santi-bnt/C.U.T.Y/hardware/README.md

# C.U.T.Y Hardware

Dos áreas: [CAD](cad/README.md), con fuentes nativas SolidWorks y exportaciones, y [electrónica](electronics/README.md), con KiCad, esquemas y datasheets. El firmware sigue separado en `../stm32/`. No se han convertido ni sustituido diseños.

- **Carcasa imprimible V17 «Nido»:** [cad/carcasa_v17](cad/carcasa_v17/LEEME.md), 30 piezas que se arman sin pegamento.
- **Carcasa V17 fija:** [cad/carcasa_v17_fija](cad/carcasa_v17_fija/LEEME.md), la misma carcasa sobre un pedestal bajo, sin movimiento en la base (27 piezas, 3 servos, 31.6 cm).
- **Placa base v1.1, pedida ensamblada a JLCPCB:** [electronics/kicad/cuty_carrier/fab/jlcpcb](electronics/kicad/cuty_carrier/fab/jlcpcb/LEEME_JLCPCB.md) (archivos subidos y correcciones del visor). Los de PCBWay quedan como alternativa en [fab/pcba](electronics/kicad/cuty_carrier/fab/pcba/LEEME_PCBA.md).
- **Lista de materiales real:** [docs/bom.md](../docs/bom.md).
