santi-bnt/C.U.T.Y/raspberry/README.md

# C.U.T.Y — Phase 1

C.U.T.Y is a small voice companion running on a Windows PC. Speak into the computer microphone and hear a streamed reply through the computer speakers. A live audio session keeps conversational context until you quit. No robot hardware is used. Gemini Live is the default provider because its selected native-audio model has a limited free API tier; OpenAI remains optional.

## Windows 11 setup

In PowerShell, from the repository root, first run `cd raspberry`:

```powershell
python -m venv .venv
.\.venv\Scripts\Activate.ps1
python -m pip install -r requirements.txt
```

If PowerShell blocks activation, use `.\.venv\Scripts\python.exe` in place of `python` for the commands below.

Create a free-tier API key in [Google AI Studio](https://aistudio.google.com/app/apikey). Keep the project on the Free tier if you do not want billing. Enter the key for the current PowerShell session:

```powershell
$env:GEMINI_API_KEY = Read-Host "Enter your Gemini API key"
```

Or copy `.env.example` to `.env` and replace `your_key_here` with the real value. `.env` is ignored by Git. An existing `GEMINI_API_KEY` environment variable takes precedence over `.env`. The key is never logged. Do not share it or commit it. A previously set `OPENAI_API_KEY` does not affect the default Gemini provider.

List audio devices without an API key:

```powershell
python -m cuty --list-audio-devices
```

To check whether Windows is delivering your voice to C.U.T.Y, run this without an API key and speak normally for three seconds:

```powershell
python -m cuty --test-microphone
```

`Peak` and `RMS` should rise above zero while you speak. This test does not save or transmit the recording. If the level stays near zero, check Windows microphone privacy permissions, mute/input volume, and the chosen device.

Choose device indices from that list if the defaults do not work:

```powershell
$env:CUTY_AUDIO_INPUT_DEVICE = "1"
$env:CUTY_AUDIO_OUTPUT_DEVICE = "4"
```

At startup C.U.T.Y opens each selected device briefly to check that it works. If a Windows default uses a failing MME driver, it tries another interface for the same named device. Device indices can change when a headset or other audio device is connected.

Start C.U.T.Y:

```powershell
python -m cuty
```

Press ENTER to start recording, speak, and press ENTER again to stop. C.U.T.Y streams its spoken answer. Repeat for another turn; say your name, then ask it to recall your name. Type `q` and ENTER at the idle prompt to quit. The current mode waits for each answer before you can speak again.

C.U.T.Y is instructed to answer in the language of your latest spoken question automatically, switching between turns (English in, English out; Spanish in, Spanish out; likewise for other languages supported by the voice model). An explicit request for a particular response language takes priority. Mixed-language questions use their main language. This applies to AI replies; the fixed local thinking asides described below are still Spanish. Restart the app after changing the instructions in `src/cuty/brain/personality.py` so a new session receives them.

During waits longer than five seconds, C.U.T.Y can say one brief Spanish aside, such as "Dame un momento" or "Estoy revisando". Fast replies have no filler. Once an aside starts, it finishes before the answer plays, so phrases are not cut off or mixed with the reply. Errors and leaving the conversation stop it after the current small audio chunk. `src/cuty/audio/thinking.py` contains the editable phrase list. The phrases use a separate Mexican Spanish voice through [Edge TTS](https://github.com/rany2/edge-tts), which needs internet but no additional API key. Only fixed phrases are sent to this service, never microphone recordings or conversation contents. They are cached in memory; if the service fails, conversation still works without asides.

In a successful turn, expect `[AI] Connected to Gemini Live` once, then `[CUTY] STATE -> LISTENING`, `THINKING`, `SPEAKING`, and `IDLE`. `[CUTY FACE]` lines show baseline expressions and any emotion chosen by the model.

The default model is `gemini-3.8-live`, Google's current stable Live model for low-latency voice agents. Its audio input and output are listed as free on the Gemini API Free tier, subject to quotas. Free-tier content may be used to improve Google products. Check Google's [models](https://ai.google.dev/gemini-api/docs/models) and [pricing](https://ai.google.dev/gemini-api/docs/pricing) pages for current availability and limits. Do not enable billing on the AI Studio project if you want a firm no-charge boundary.

Gemini can call `search_web` for current information through the public DDGS search library, without another API key or a Google Search API quota. Ask, for example, "Busca en internet cuál es la versión estable actual de Python y dime la fuente." C.U.T.Y replies by voice and logs actual queries and source links as `[WEB]`. Ordinary conversation does not need a search; a lookup may take longer. Searches return public page excerpts, not full browser sessions or actions on websites. The public search engines can rate-limit or become unavailable; C.U.T.Y reports an unsuccessful search instead of inventing a verified answer. This integration avoids the Gemini Live Google Search quota restriction observed on the configured free project. The optional OpenAI adapter does not enable this search tool.

## ReSpeaker on the Pi, reply audio on a Windows PC

Run the voice app on the Raspberry Pi, where the ReSpeaker is connected.
The PC only receives reply audio. Both machines need the Python dependencies
above. This temporary setup uses an SSH reverse tunnel, with the audio
receiver listening only on localhost; no Windows inbound firewall rule is needed.

On the PC, open PowerShell in `raspberry`, list devices, choose the index of
your PC speakers (not the ReSpeaker), and leave the receiver running:

```powershell
.\.venv\Scripts\python.exe -m cuty --list-audio-devices
$env:CUTY_AUDIO_OUTPUT_DEVICE = "3" # Replace with your Speakers index
.\.venv\Scripts\python.exe -m cuty --serve-audio
```

In a second PC terminal, connect to the Pi (replace the user and host):

```powershell
ssh -o ExitOnForwardFailure=yes -R 8765:127.0.0.1:8765 santi@RASPBERRY_IP
```

Inside that SSH session, from the repository root on the Pi:

```bash
git pull --ff-only origin main
cd raspberry
source .venv/bin/activate
python -m pip install -r requirements.txt
python -m cuty --list-audio-devices
export CUTY_AUDIO_INPUT_DEVICE="N" # Replace N with the ReSpeaker input index
python -m cuty --test-microphone
export CUTY_AUDIO_REMOTE_OUTPUT="127.0.0.1:8765"
# Configure GEMINI_API_KEY locally on the Pi if it is not already in .env.
python -m cuty
```

If no virtual environment exists on the Pi, create it first with
`python3 -m venv .venv`. Speak during the three-second microphone test;
Peak and RMS should rise above zero. Then press ENTER, speak into the Pi's
ReSpeaker, and press ENTER again: the reply plays on the PC. Keep both PC
terminals open. Ctrl+C stops the receiver; `q` quits the voice app.
Unset `CUTY_AUDIO_REMOTE_OUTPUT` to restore local Pi playback.
If the ReSpeaker does not appear on the Pi, its USB/HAT setup must be resolved
before testing the voice app. Lip sync still runs on the Pi; network latency
may require adjusting `CUTY_LIPSYNC_DELAY`.

## Conversación automática en la pantalla

El botón C.U.T.Y del menú inicia una sesión Gemini con saludo hablado y
escucha sin ENTER. Di «salir», «quiero salir» o «regresa al menú principal»
cuando escuche para volver al inicio. El launcher utiliza este entorno
virtual y carga `raspberry/.env`; no recibe las variables exportadas en una
terminal SSH. Consulta la [configuración del menú](touchscreen/README.md#conversación-desde-el-menú).

Para probar ese modo desde una terminal: `python -m cuty --hands-free`.
La CLI habitual `python -m cuty` conserva los turnos con ENTER.

## Tests

```powershell
python -m pytest -q
```

Tests use fakes and never call either AI API or require audio hardware. A real voice test requires a valid Gemini key, an accessible microphone and speaker, network access, and free-tier model access in your account. Override the Gemini model with `CUTY_GEMINI_MODEL` only if Google's availability changes.

The CLI logs connection and state changes, expression events, assistant transcripts, and Gemini's input transcription as `Escuché: ...`. If the local microphone test shows voice but no `Escuché` line appears during a turn, check that you spoke after the first ENTER and pressed ENTER again only after finishing. If microphone capture or speaker playback fails, check Windows microphone permission and try a different device index. If a connection fails temporarily, startup retries three times with short exponential delays. A disconnect during a turn ends the program so it does not silently lose session memory; start it again for a new session.

## Architecture

Hands-free voice and local Music Mode have independent software output volume
controls. See [volume commands and Raspberry Pi validation](../docs/voice-volume.md).
Vision timing, Gemini request diagnosis, and the opt-in high-resolution camera
experiment are documented in [vision performance](../docs/vision-performance.md).

`src/cuty/brain/` owns conversation and states; `llm/` owns both cloud providers and web lookup; `audio/` owns microphone, speaker, and thinking asides. `src/cuty/main.py` is the entry point and `app.py` wires the CLI. `face/` contains expression events, the animated touchscreen face and the UDP link that carries expressions and lip-sync levels to it; `vision/` tracks the person for the eyes. Other robot modules are placeholders; see [architecture](../docs/architecture.md).

Baseline expressions follow `IDLE`, `LISTENING`, `THINKING`, and `SPEAKING` states. The model may call `set_expression` for a temporary emotion. Invalid tool arguments are rejected and returned to the model without emitting a robot event. No keyword-based emotion matching is used. There is no serial transport or defined UART protocol in this phase.

Gemini Live uses explicit activity boundaries: the first microphone chunk starts the user turn, and ENTER sends its end immediately. This avoids a separate server-side silence wait and prevents premature responses during a pause. Input is native 16 kHz PCM and output is 24 kHz PCM. Server events and speaker playback run independently, so expression tool results are submitted while audio plays. Expression calls explicitly use blocking mode so Gemini resumes speech after the result instead of silently completing an expression-only turn. The CLI logs `Primera voz en ... s` from the end of recording to the first playback chunk and reports an error if no voice arrives in 15 seconds or the server finishes without audio. The session keeps context in memory on the live connection. There is no long-term memory, wake word, hands-free turn control, or barge-in in Phase 1.

Implementation references: [Gemini Live capabilities](https://ai.google.dev/gemini-api/docs/live-api/capabilities) and [Gemini Live tools](https://ai.google.dev/gemini-api/docs/live-api/tools).

To use the optional OpenAI provider instead, set `CUTY_AI_PROVIDER=openai` and `OPENAI_API_KEY` in the environment; its default model is `gpt-realtime-2.1`. OpenAI API usage is billed separately. The earlier OpenAI integration and tests remain available.

## Later Raspberry Pi OS deployment

The same Python package is intended to install on 64-bit Raspberry Pi OS:

```bash
git clone <repository-url>
cd <repository-directory>/raspberry
python3 -m venv .venv
source .venv/bin/activate
python -m pip install -r requirements.txt
export GEMINI_API_KEY='your-real-key'
python -m cuty
```

The sample `systemd/cuty.service` is a placeholder for a later phase. This Phase 1 CLI needs keyboard input, so the unit should not be activated until a noninteractive interaction mode is added and tested on the Pi.

## Raspberry touchscreen

The [touch menu, animated face and Wi-Fi panel](touchscreen/README.md) live in `touchscreen/`. The C.U.T.Y button starts hands-free Gemini voice, expressions and lip sync, with a spoken exit back to the menu. Screen dependencies are in `touchscreen/requirements.txt` and are not required for Windows voice development. Setup helpers live in `scripts/` within this Raspberry directory.

## Local Music Mode (experimental; physical Pi validation required)

In touchscreen hands-free mode, voice transcripts are checked by a deterministic Spanish/English command parser. The first provider is a local file library; no audio is bundled. Put audio you are authorized to play under `~/Music/CUTY` (or set `CUTY_MUSIC_DIR`) and optionally set `CUTY_MUSIC_VOLUME` from 0 to 100. Supported containers are WAV, MP3, FLAC, OGG, and M4A when the installed PyAV/FFmpeg build can decode them. Commands include play/search, pause, continue, stop, next, previous, volume up/down/set, and current-track query. The local provider uses the existing speaker and PyAV dependency; music output is deliberately kept outside the speech lip-sync wrapper. The face process remains independent and receives a gentle happy expression during music, not beat-synchronized animation.

The existing hands-free application uses half-duplex audio: it pauses music and closes the output stream while the microphone records, then resumes music after the voice reply if it was playing. When a local track starts, hands-free waits for that track to finish before reopening its microphone; this allows an initial full-track speaker/face test without falsely claiming voice interruption works. Voice pause/stop/volume commands therefore do not work during active playback yet. This is **not automatic volume ducking** and it is not acoustic echo cancellation. `--test-duplex` only tests a silent output stream while capturing the microphone; it does not prove audible speaker output or safe voice recognition over music. Validate actual speaker playback, ReSpeaker simultaneous capture/playback, echo, VAD, and volume behavior on the robot before enabling interruption or ducking.

On-demand voice vision and consent-based local face matching reuse the touchscreen FaceTracker camera. They require a separately installed OpenCV-contrib/SFace model and remain unvalidated on the Raspberry Pi; setup, privacy limits and required checks are in [`docs/face-vision.md`](../docs/face-vision.md).

There is no website backend, authentication, pairing, or robot transport in this repository: `web/src/communication/robot.ts` is explicitly an offline interface. No browser playback controls or public robot endpoint were added. A secure live dashboard requires an authenticated server/relay and device pairing, which are not present to integrate; credentials must not be placed in the static website. YouTube playback is not implemented. Its official APIs do not authorize extracting audio or hiding/playing audio in the background, so this local speaker provider is the compatible first step.
