santi-bnt/C.U.T.Y/stm32/Core/README.md

# STM32 Core

Reserved for the STM32F401 Black Pill board-specific startup, interrupt, and HAL initialization project. Confirm the exact MCU variant and board revision before generation. No generated or vendor code is present.
