santi-bnt/C.U.T.Y/stm32/Drivers/README.md

# STM32 Drivers

Reserved for STM32F401-compatible CMSIS/HAL and device drivers for the Black Pill. Keep vendor licensing and versions with imported code; no drivers are supplied now.
