santi-bnt/C.U.T.Y/web/digital-twin/README.md

# Digital Twin Placeholder

models/ and animations/ will hold web visualization assets. Derive geometry from reviewed CAD exports; these are not mechanical source-of-truth files. No renderer or simulation is implemented.
