santi-bnt/C.U.T.Y/docs/protocol/README.md

# C.U.T.Y Shared Contracts

Hardware-independent design documents for Raspberry ↔ STM32 ↔ telemetry consumers. [Protocol](protocol.md), [commands](commands.md), and [telemetry](telemetry.md) are proposals, not implemented or stable contracts. Keep board drivers and UI code out of this folder.
