santi-bnt/C.U.T.Y/web/dashboard/README.md

# Dashboard Placeholder

No application is implemented. Future telemetry views are listed in ../README.md. Select transport/framework only in a later dashboard task.
