santi-bnt/C.U.T.Y/stm32/App/imu/README.md

# STM32 IMU

Future sensor initialization, acquisition, calibration, orientation estimation, timestamps, and validity reporting. Outputs feed STM32 body control and telemetry.

No sensor model, bus, driver, sample rate, or coordinate frame is selected. C/H files are TODO-only. The Raspberry and web dashboard consume reported measurements; they do not own the real-time feedback loop.
