santi-bnt/C.U.T.Y/hardware/electronics/kicad/cuty_carrier/drc_report.txt

** Drc report for /home/claude/c.u.t.y/hardware/electronics/kicad/cuty_carrier/cuty_carrier.kicad_pcb **
** Created on 2026-11-04 17:50:28 **

** Found 50 DRC violations **
[silk_overlap]: Silkscreen overlap
    Rule: board setup constraints silk; Severity: warning
    @(126.5600 mm, 51.2000 mm): PCB Text 'SW PRINCIPAL' on F.Silkscreen
    @(131.7000 mm, 51.5000 mm): Line on F.Silkscreen
[silk_overlap]: Silkscreen overlap
    Rule: board setup constraints silk; Severity: warning
    @(126.5600 mm, 51.2000 mm): PCB Text 'SW PRINCIPAL' on F.Silkscreen
    @(121.4200 mm, 60.8610 mm): Line on F.Silkscreen
[silk_overlap]: Silkscreen overlap
    Rule: board setup constraints silk; Severity: warning
    @(126.5600 mm, 51.2000 mm): PCB Text 'SW PRINCIPAL' on F.Silkscreen
    @(131.7000 mm, 50.9400 mm): Line on F.Silkscreen
[silk_overlap]: Silkscreen overlap
    Rule: board setup constraints silk; Severity: warning
    @(126.5600 mm, 53.0000 mm): Reference 'J2'
    @(131.7000 mm, 53.0000 mm): Line on F.Silkscreen
[silk_overlap]: Silkscreen overlap
    Rule: board setup constraints silk; Severity: warning
    @(129.0000 mm, 66.2000 mm): Reference 'F2'
    @(128.2100 mm, 66.2000 mm): Line on F.Silkscreen
[silk_overlap]: Silkscreen overlap
    Rule: board setup constraints silk; Severity: warning
    @(131.7000 mm, 60.8610 mm): Line on F.Silkscreen
    @(126.5600 mm, 51.2000 mm): PCB Text 'SW PRINCIPAL' on F.Silkscreen
[silk_overlap]: Silkscreen overlap
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
[silk_overlap]: Silkscreen overlap
    Rule: board setup constraints silk; Severity: warning
    @(197.4010 mm, 135.6138 mm): Footprint Text '5V' of U1
    @(198.3980 mm, 135.4952 mm): Rect on F.Silkscreen
[silk_overlap]: Silkscreen overlap
    Rule: board setup constraints silk; Severity: warning
    @(149.1000 mm, 120.0000 mm): Reference 'D1'
    @(146.3600 mm, 119.5700 mm): Line on F.Silkscreen
[silk_overlap]: Silkscreen overlap
    Rule: board setup constraints silk; Severity: warning
    @(138.7600 mm, 51.2000 mm): PCB Text 'BUCK IN' on F.Silkscreen
    @(143.9000 mm, 51.5000 mm): Line on F.Silkscreen
[silk_overlap]: Silkscreen overlap
    Rule: board setup constraints silk; Severity: warning
    @(138.7600 mm, 51.2000 mm): PCB Text 'BUCK IN' on F.Silkscreen
    @(143.9000 mm, 50.9400 mm): Line on F.Silkscreen
[silk_overlap]: Silkscreen overlap
    Rule: board setup constraints silk; Severity: warning
    @(138.7600 mm, 53.0000 mm): Reference 'J4'
    @(143.9000 mm, 53.0000 mm): Line on F.Silkscreen
[silk_overlap]: Silkscreen overlap
    Rule: board setup constraints silk; Severity: warning
    @(150.9600 mm, 51.2000 mm): PCB Text 'SW SERVOS' on F.Silkscreen
    @(156.1000 mm, 50.9400 mm): Line on F.Silkscreen
[silk_overlap]: Silkscreen overlap
    Rule: board setup constraints silk; Severity: warning
    @(150.9600 mm, 51.2000 mm): PCB Text 'SW SERVOS' on F.Silkscreen
    @(156.1000 mm, 51.5000 mm): Line on F.Silkscreen
[silk_overlap]: Silkscreen overlap
    Rule: board setup constraints silk; Severity: warning
    @(150.9600 mm, 53.0000 mm): Reference 'J3'
    @(156.1000 mm, 53.0000 mm): Line on F.Silkscreen
[silk_overlap]: Silkscreen overlap
    Rule: board setup constraints silk; Severity: warning
    @(149.0000 mm, 66.2000 mm): Reference 'F1'
    @(148.2100 mm, 66.2000 mm): Line on F.Silkscreen

** Found 0 unconnected pads **

** Found 0 Footprint errors **

** End of Report **
