santi-bnt/C.U.T.Y/hardware/electronics/kicad/cuty_carrier/fab/drc_report.txt

** Drc report for /home/claude/c.u.t.y/hardware/electronics/kicad/cuty_carrier/cuty_carrier.kicad_pcb **
** Created on 2026-11-03 05:46:13 **

** Found 50 DRC violations **
[silk_overlap]: Silkscreen overlap
    Rule: board setup constraints silk; Severity: warning
    @(117.8000 mm, 80.0000 mm): Reference 'R9'
    @(114.5400 mm, 80.4300 mm): Line on F.Silkscreen
[silk_overlap]: Silkscreen overlap
    Rule: board setup constraints silk; Severity: warning
    @(101.5000 mm, 94.0800 mm): PCB Text '+6V' on F.Silkscreen
    @(100.8400 mm, 86.4000 mm): Line on F.Silkscreen
[silk_overlap]: Silkscreen overlap
    Rule: board setup constraints silk; Severity: warning
    @(101.5000 mm, 94.0800 mm): PCB Text '+6V' on F.Silkscreen
    @(101.4000 mm, 86.4000 mm): Line on F.Silkscreen
[silk_overlap]: Silkscreen overlap
    Rule: board setup constraints silk; Severity: warning
    @(101.5000 mm, 94.0800 mm): PCB Text '+6V' on F.Silkscreen
    @(102.9000 mm, 86.4000 mm): Line on F.Silkscreen
[silk_overlap]: Silkscreen overlap
    Rule: board setup constraints silk; Severity: warning
    @(101.4000 mm, 86.4000 mm): Line on F.Silkscreen
    @(101.2000 mm, 89.0000 mm): PCB Text '-' on F.Silkscreen
[silk_overlap]: Silkscreen overlap
    Rule: board setup constraints silk; Severity: warning
    @(100.8400 mm, 86.4000 mm): Line on F.Silkscreen
    @(101.2000 mm, 89.0000 mm): PCB Text '-' on F.Silkscreen
[silk_overlap]: Silkscreen overlap
    Rule: board setup constraints silk; Severity: warning
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
    @(101.2000 mm, 77.5000 mm): PCB Text '+' on F.Silkscreen
    @(101.4000 mm, 74.9000 mm): Line on F.Silkscreen
[silk_overlap]: Silkscreen overlap
    Rule: board setup constraints silk; Severity: warning
    @(101.2000 mm, 77.5000 mm): PCB Text '+' on F.Silkscreen
    @(100.8400 mm, 74.9000 mm): Line on F.Silkscreen
[silk_overlap]: Silkscreen overlap
    Rule: board setup constraints silk; Severity: warning
    @(126.5600 mm, 51.2000 mm): PCB Text 'SW PRINCIPAL' on F.Silkscreen
    @(131.7000 mm, 51.5000 mm): Line on F.Silkscreen
[silk_overlap]: Silkscreen overlap
    Rule: board setup constraints silk; Severity: warning
    @(126.5600 mm, 51.2000 mm): PCB Text 'SW PRINCIPAL' on F.Silkscreen
    @(121.4200 mm, 60.8610 mm): Line on F.Silkscreen
[silk_overlap]: Silkscreen overlap
    Rule: board setup constraints silk; Severity: warning
    @(126.5600 mm, 51.2000 mm): PCB Text 'SW PRINCIPAL' on F.Silkscreen
    @(131.7000 mm, 50.9400 mm): Line on F.Silkscreen
[silk_overlap]: Silkscreen overlap
    Rule: board setup constraints silk; Severity: warning
    @(117.8000 mm, 75.2000 mm): Reference 'R10'
    @(114.5400 mm, 75.6300 mm): Line on F.Silkscreen
[silk_overlap]: Silkscreen overlap
    Rule: board setup constraints silk; Severity: warning
    @(126.5600 mm, 53.0000 mm): Reference 'J2'
    @(131.7000 mm, 53.0000 mm): Line on F.Silkscreen
[silk_overlap]: Silkscreen overlap
    Rule: board setup constraints silk; Severity: warning
    @(126.5600 mm, 51.2000 mm): PCB Text 'SW PRINCIPAL' on F.Silkscreen
    @(131.7000 mm, 60.8610 mm): Line on F.Silkscreen
[silk_overlap]: Silkscreen overlap
    Rule: board setup constraints silk; Severity: warning
    @(129.0000 mm, 66.2000 mm): Reference 'F2'
    @(128.2100 mm, 66.2000 mm): Line on F.Silkscreen

** Found 0 unconnected pads **

** Found 0 Footprint errors **

** End of Report **
