santi-bnt/C.U.T.Y/hardware/cad/carcasa_v17/renders/espalda_34.png

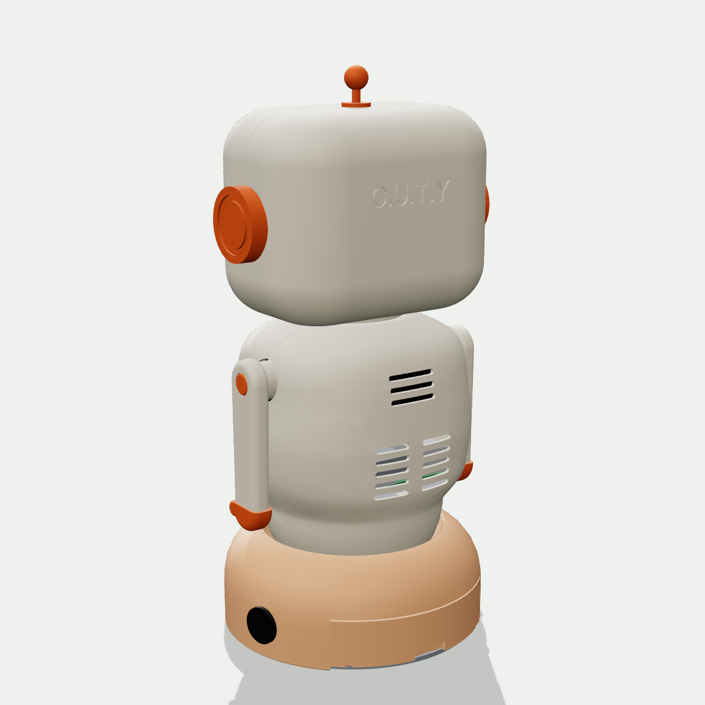
hardware/cad/carcasa_v17/renders/espalda_34.png
