santi-bnt/C.U.T.Y/hardware/cad/carcasa_v17/renders/lado.png

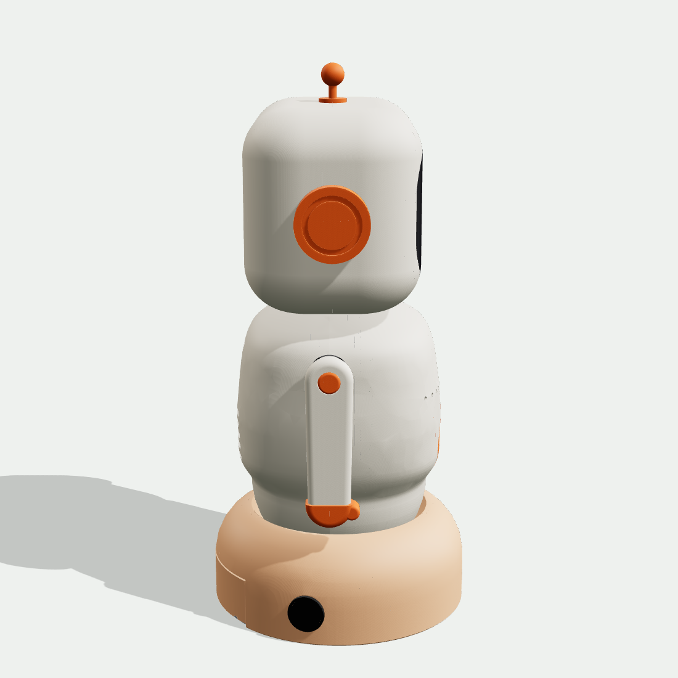
hardware/cad/carcasa_v17/renders/lado.png
