santi-bnt/C.U.T.Y/hardware/electronics/kicad/cuty_carrier/fab/preview/cuty_carrier_bottom.png

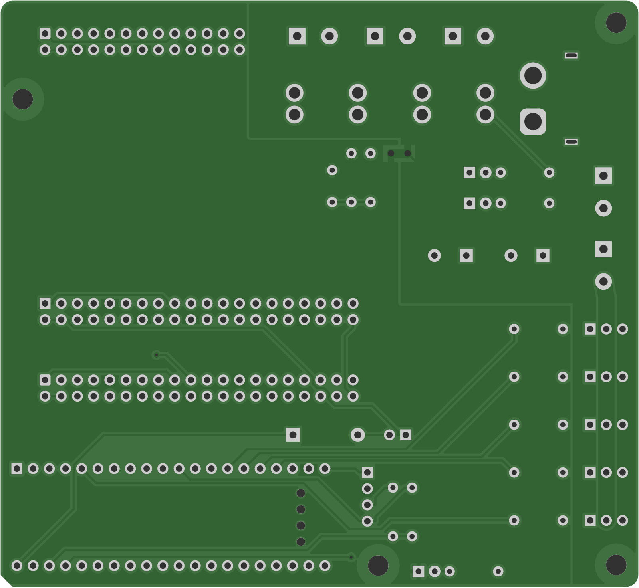
hardware/electronics/kicad/cuty_carrier/fab/preview/cuty_carrier_bottom.png
