santi-bnt/C.U.T.Y/hardware/cad/carcasa_v17/STL_imprimir/H1_Head_Front.stl

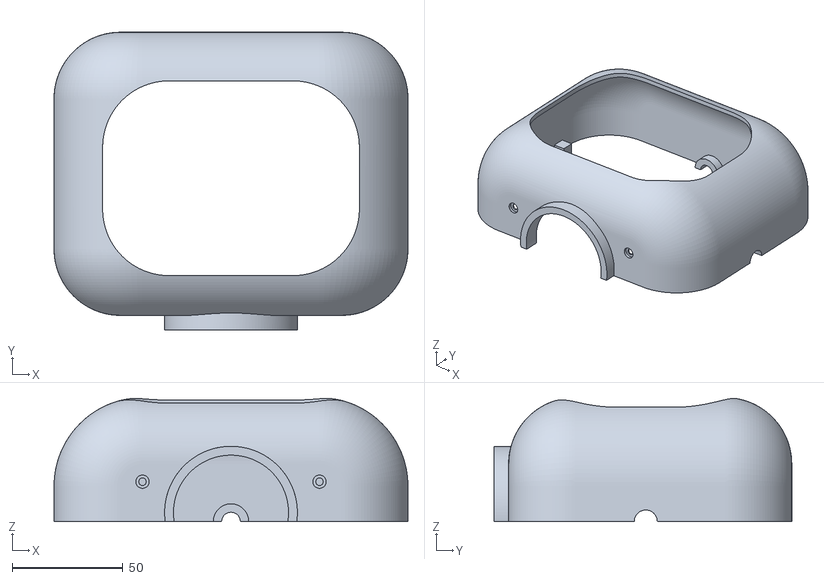
[picture p6: CAD file, 2026-11-13]
hardware/cad/carcasa_v17/STL_imprimir/H1_Head_Front.stl
160.0 x 134.5 x 55.6
