santi-bnt/C.U.T.Y/hardware/cad/carcasa_v17_fija/STL_imprimir/A2_Arm_R.stl

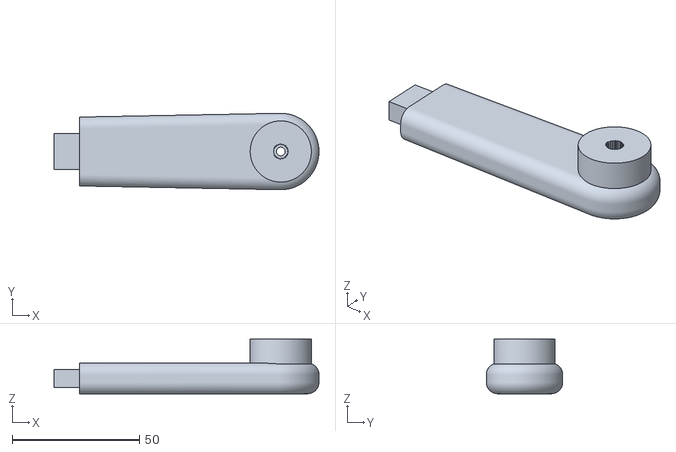
[picture p7: CAD file, 2026-11-13]
hardware/cad/carcasa_v17_fija/STL_imprimir/A2_Arm_R.stl
104.0 x 30.0 x 21.4
