santi-bnt/C.U.T.Y/hardware/cad/carcasa_v17/STL_imprimir/S4_USB_Plug.stl

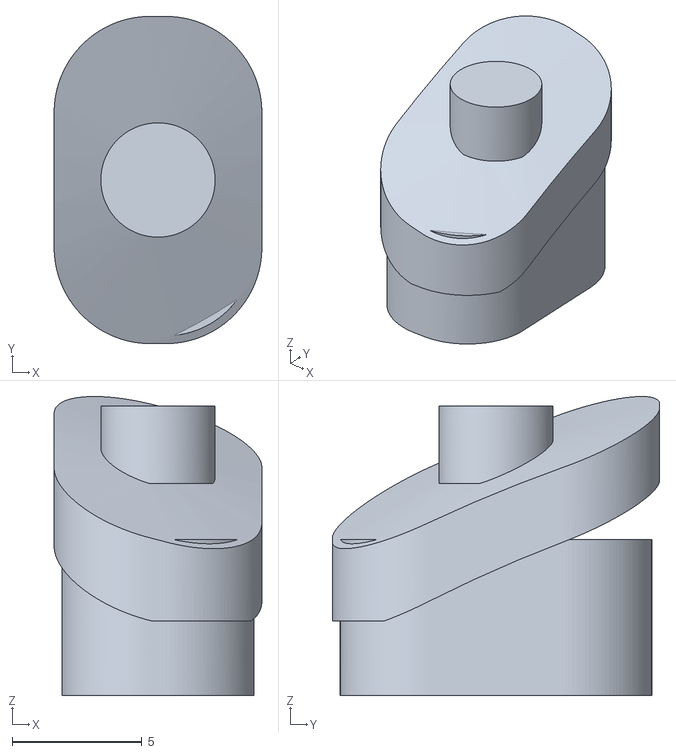
[picture p8: CAD file, 2026-11-13]
hardware/cad/carcasa_v17/STL_imprimir/S4_USB_Plug.stl
8.00 x 12.6 x 11.5
