santi-bnt/C.U.T.Y/hardware/cad/carcasa_v17_fija/STL_imprimir/H2_Head_Back.stl

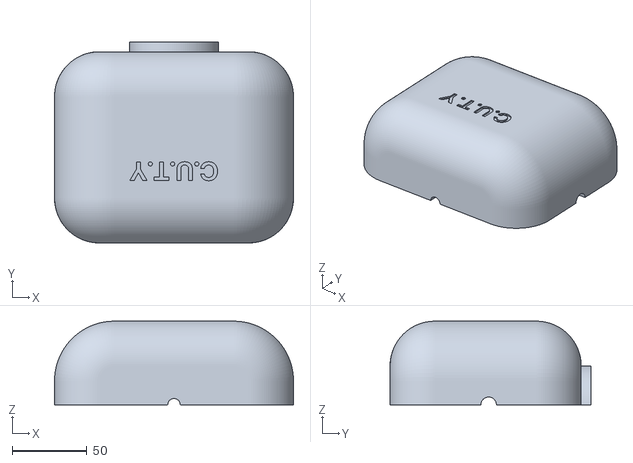
[picture p9: CAD file, 2026-11-13]
hardware/cad/carcasa_v17_fija/STL_imprimir/H2_Head_Back.stl
160.0 x 134.5 x 56.0
