santi-bnt/C.U.T.Y/hardware/cad/carcasa_v17/STL_imprimir/B1_Base_Cover.stl

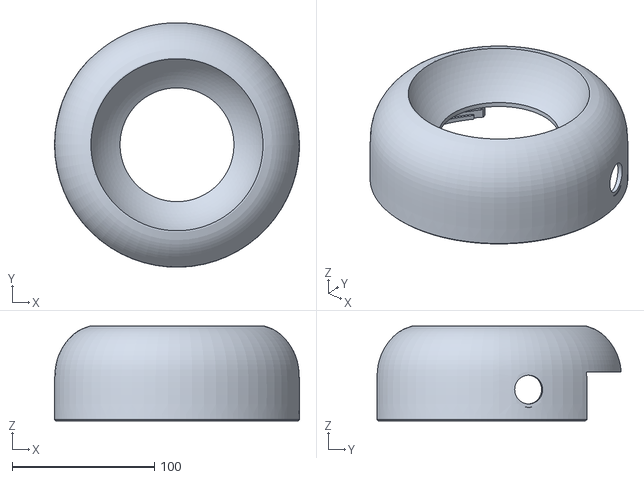
[picture p10: CAD file, 2026-11-13]
hardware/cad/carcasa_v17/STL_imprimir/B1_Base_Cover.stl
172.2 x 171.9 x 66.6
