santi-bnt/C.U.T.Y/hardware/cad/carcasa_v17_fija/STL_imprimir/B4_Deck_Riser.stl

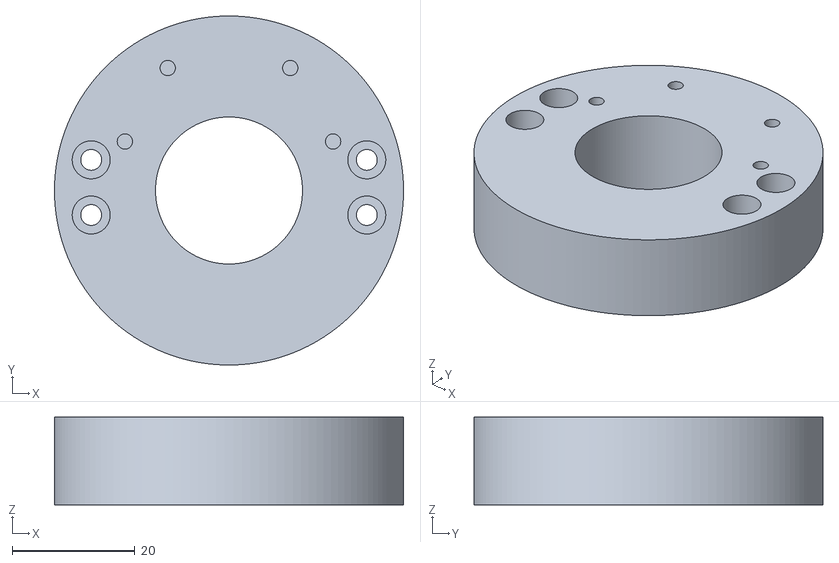
[picture p11: CAD file, 2026-11-13]
hardware/cad/carcasa_v17_fija/STL_imprimir/B4_Deck_Riser.stl
57.0 x 57.0 x 14.3
