santi-bnt/C.U.T.Y/hardware/cad/carcasa_v17/STL_imprimir/S2_Body_Back.stl

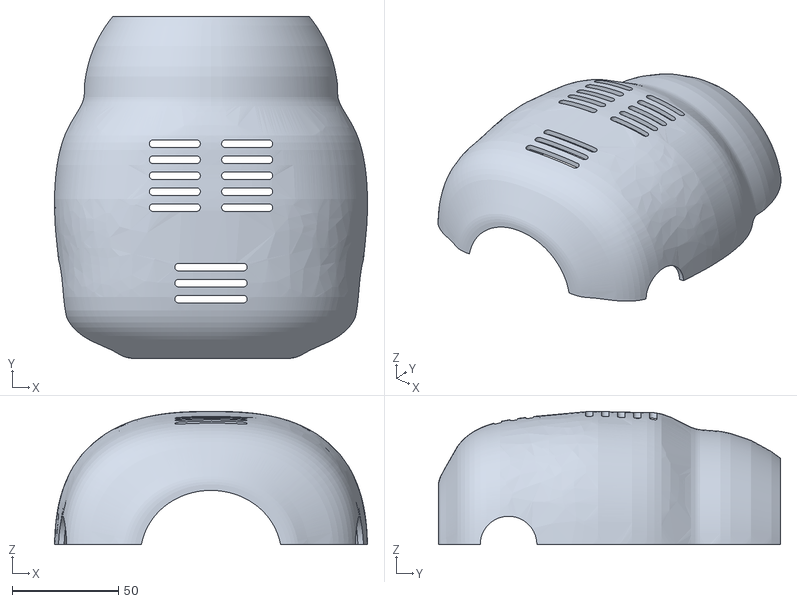
[picture p12: CAD file, 2026-11-13]
hardware/cad/carcasa_v17/STL_imprimir/S2_Body_Back.stl
147.1 x 160.9 x 62.6
