santi-bnt/C.U.T.Y/hardware/cad/carcasa_v17_fija/STL_imprimir/S1_Body_Front_Fixed.stl

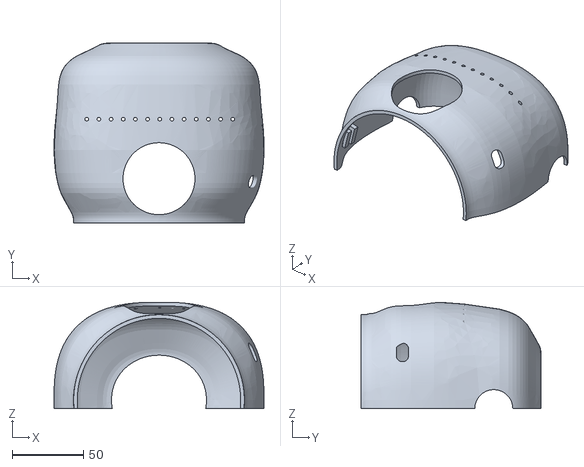
[picture p13: CAD file, 2026-11-13]
hardware/cad/carcasa_v17_fija/STL_imprimir/S1_Body_Front_Fixed.stl
147.2 x 126.0 x 74.5
