santi-bnt/C.U.T.Y/hardware/cad/carcasa_v17/STL_imprimir/K3_Core_Shoulders.stl

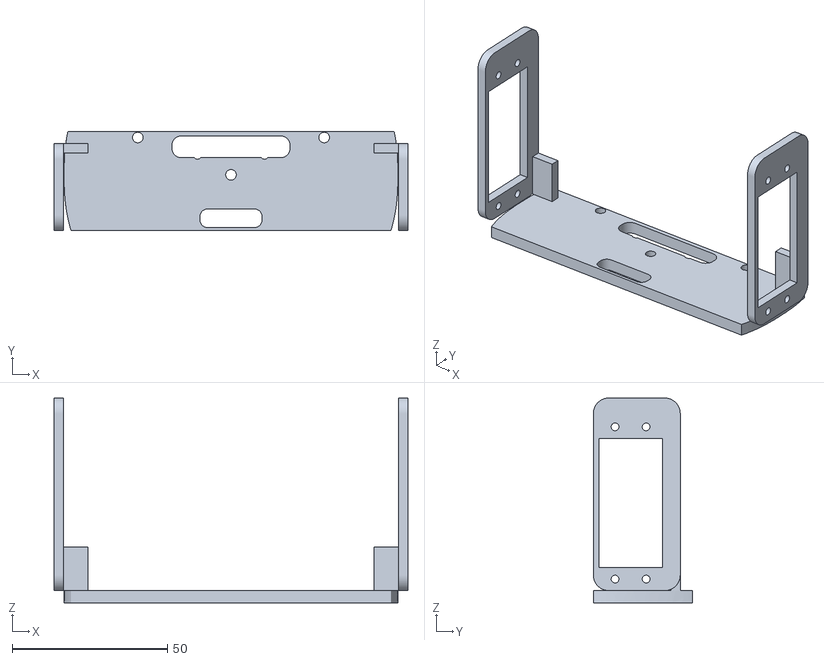
[picture p14: CAD file, 2026-11-09]
hardware/cad/carcasa_v17/STL_imprimir/K3_Core_Shoulders.stl
114.0 x 32.0 x 66.0
