santi-bnt/C.U.T.Y/hardware/cad/carcasa_v17/STL_imprimir/B3_Battery_Drawer.stl

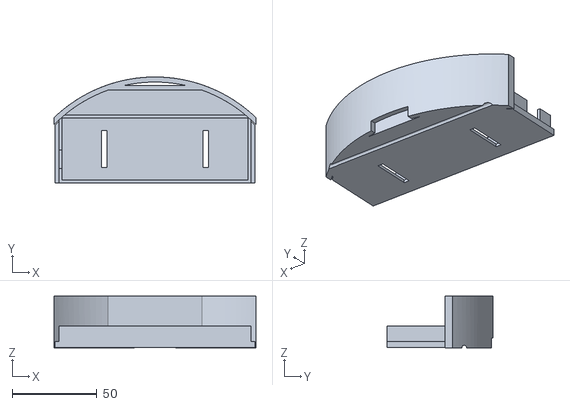
[picture p15: CAD file, 2026-11-09]
hardware/cad/carcasa_v17/STL_imprimir/B3_Battery_Drawer.stl
119.2 x 62.6 x 30.4
