santi-bnt/C.U.T.Y/hardware/cad/carcasa_v17_fija/STL_imprimir/A6_Arm_Cap_R.stl

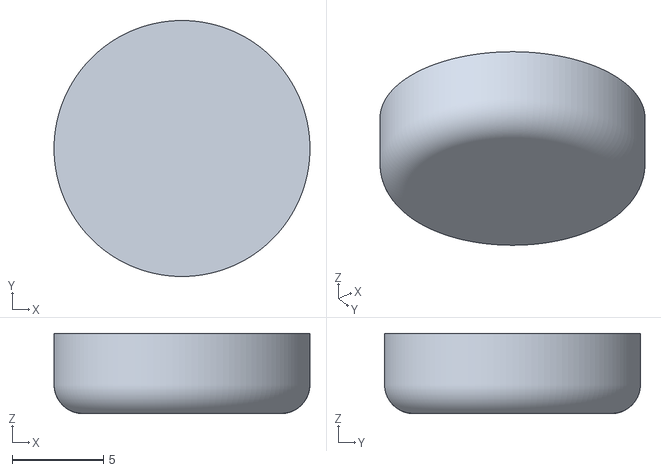
[picture p16: CAD file, 2026-11-13]
hardware/cad/carcasa_v17_fija/STL_imprimir/A6_Arm_Cap_R.stl
14.0 x 14.0 x 4.40
