santi-bnt/C.U.T.Y/hardware/cad/carcasa_v17/STL_imprimir/B2_Base_Floor.stl

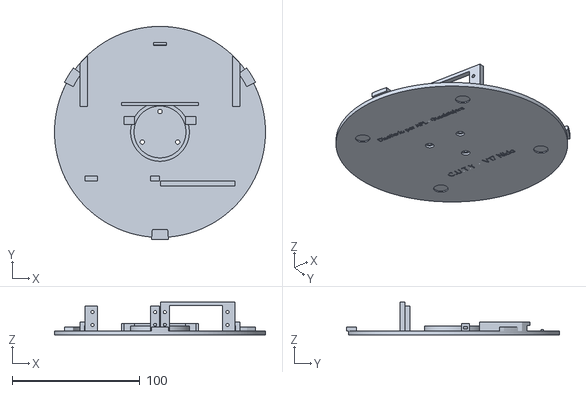
[picture p17: CAD file, 2026-11-09]
hardware/cad/carcasa_v17/STL_imprimir/B2_Base_Floor.stl
165.2 x 166.9 x 25.7
