santi-bnt/C.U.T.Y/hardware/cad/carcasa_v17_fija/STL_imprimir/A3_Hand_L.stl

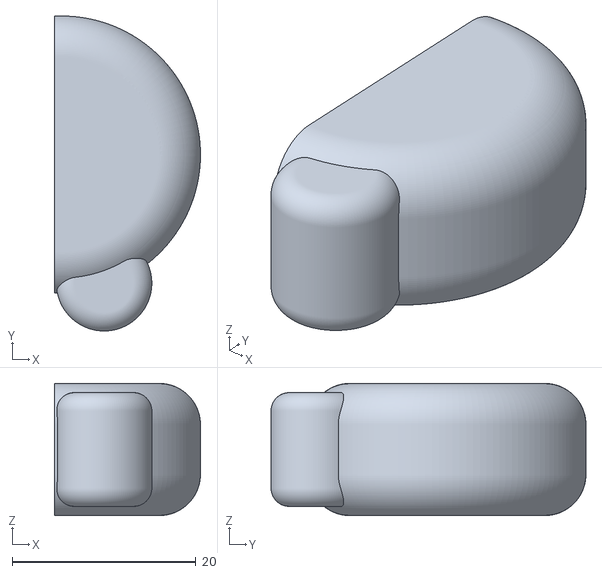
[picture p18: CAD file, 2026-11-13]
hardware/cad/carcasa_v17_fija/STL_imprimir/A3_Hand_L.stl
15.9 x 34.3 x 14.4
