santi-bnt/C.U.T.Y/hardware/cad/carcasa_v17_fija/STL_imprimir/S3_Tummy_Grille.stl

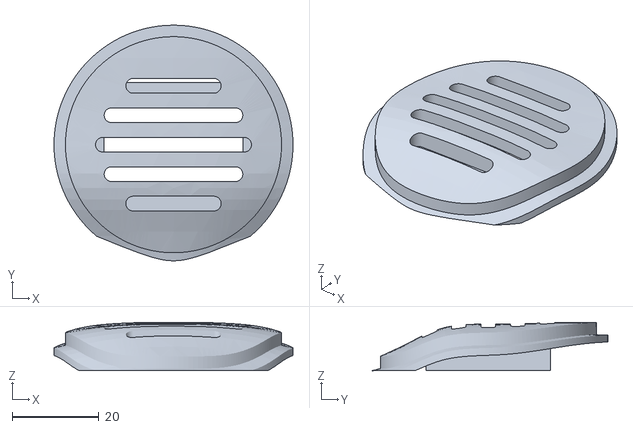
[picture p19: CAD file, 2026-11-13]
hardware/cad/carcasa_v17_fija/STL_imprimir/S3_Tummy_Grille.stl
55.2 x 54.4 x 11.2
