santi-bnt/C.U.T.Y/hardware/cad/carcasa_v17/STL_imprimir/G2_Crank_L.stl

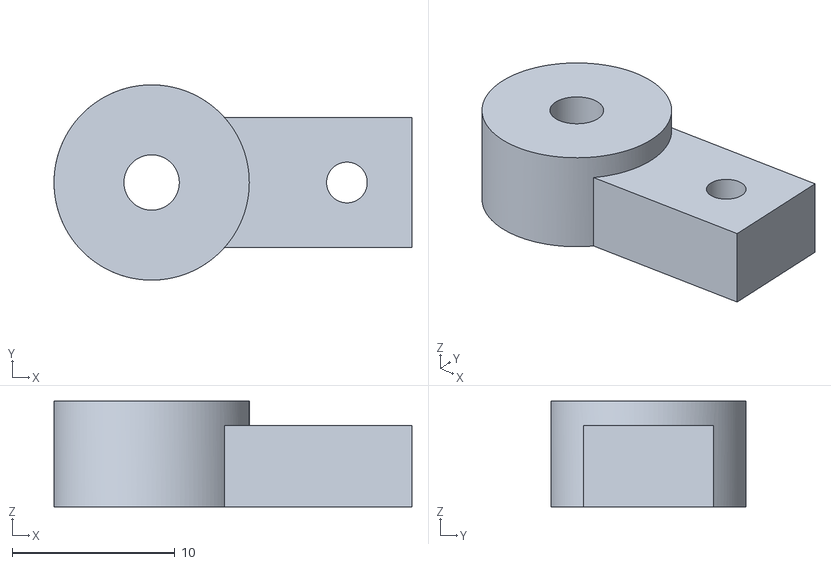
[picture p20: CAD file, 2026-11-09]
hardware/cad/carcasa_v17/STL_imprimir/G2_Crank_L.stl
22.0 x 12.0 x 6.50
