santi-bnt/C.U.T.Y/hardware/cad/carcasa_v17/STL_imprimir/H3_Visor.stl

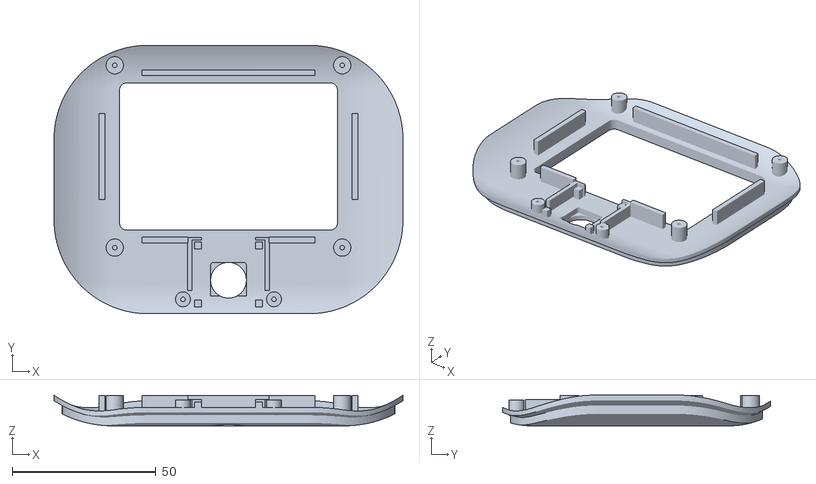
[picture p21: CAD file, 2026-11-09]
hardware/cad/carcasa_v17/STL_imprimir/H3_Visor.stl
121.2 x 93.2 x 10.7
