santi-bnt/C.U.T.Y/hardware/cad/carcasa_v17/STL_imprimir/K5_Power_Rack.stl

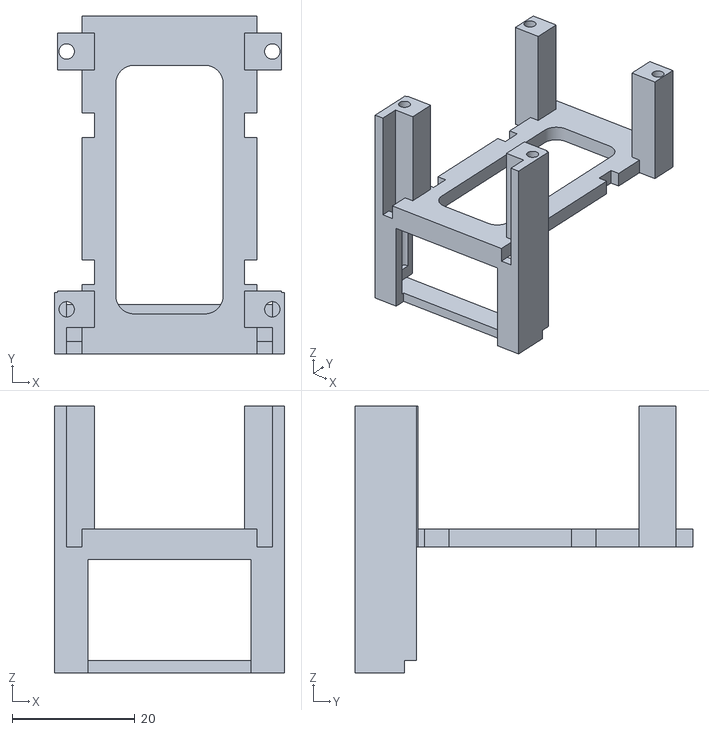
[picture p22: CAD file, 2026-11-09]
hardware/cad/carcasa_v17/STL_imprimir/K5_Power_Rack.stl
37.5 x 55.0 x 43.5
