santi-bnt/C.U.T.Y/hardware/cad/carcasa_v17/STL_imprimir/K1_Core_Deck.stl

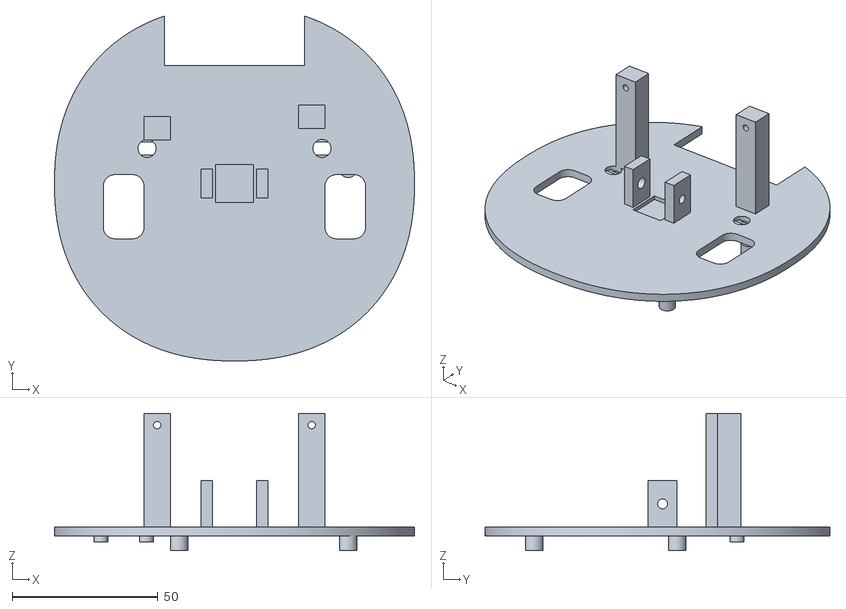
[picture p23: CAD file, 2026-11-09]
hardware/cad/carcasa_v17/STL_imprimir/K1_Core_Deck.stl
123.5 x 118.3 x 47.0
