santi-bnt/C.U.T.Y/hardware/cad/carcasa_v17/STL_imprimir/S3_Tummy_Grille.stl

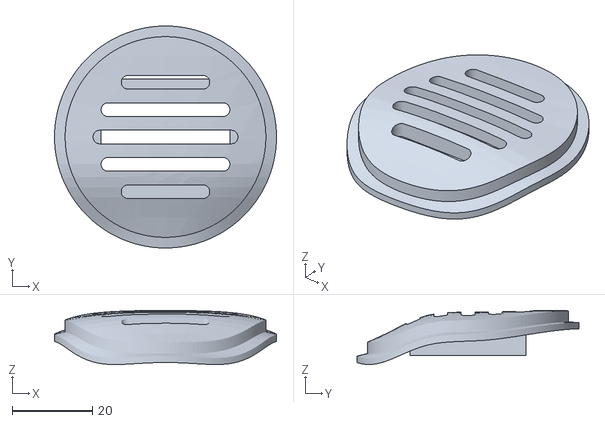
[picture p24: CAD file, 2026-11-09]
hardware/cad/carcasa_v17/STL_imprimir/S3_Tummy_Grille.stl
55.2 x 55.2 x 13.4
