santi-bnt/C.U.T.Y/hardware/cad/carcasa_v17/STL_imprimir/H5_Head_Base.stl

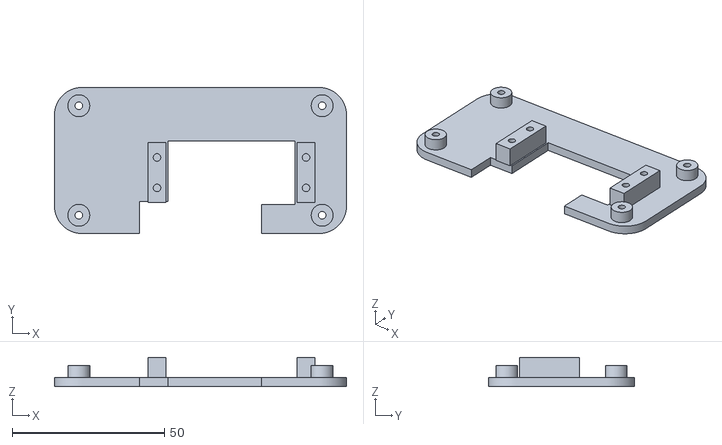
[picture p25: CAD file, 2026-11-09]
hardware/cad/carcasa_v17/STL_imprimir/H5_Head_Base.stl
96.0 x 48.0 x 9.60
