santi-bnt/C.U.T.Y/(list of files, cad)

Other CAD files:
hardware/cad/carcasa_v17_fija/STL_imprimir/S4_USB_Plug.stl
hardware/cad/carcasa_v17/STL_imprimir/A2_Arm_R.stl
hardware/cad/carcasa_v17/STL_imprimir/A6_Arm_Cap_R.stl
hardware/cad/carcasa_v17/STL_imprimir/H2_Head_Back.stl
hardware/cad/carcasa_v17/STL_imprimir/A4_Hand_R.stl
