santi-bnt/C.U.T.Y/web/public/engineering/carrier-schematic.pdf

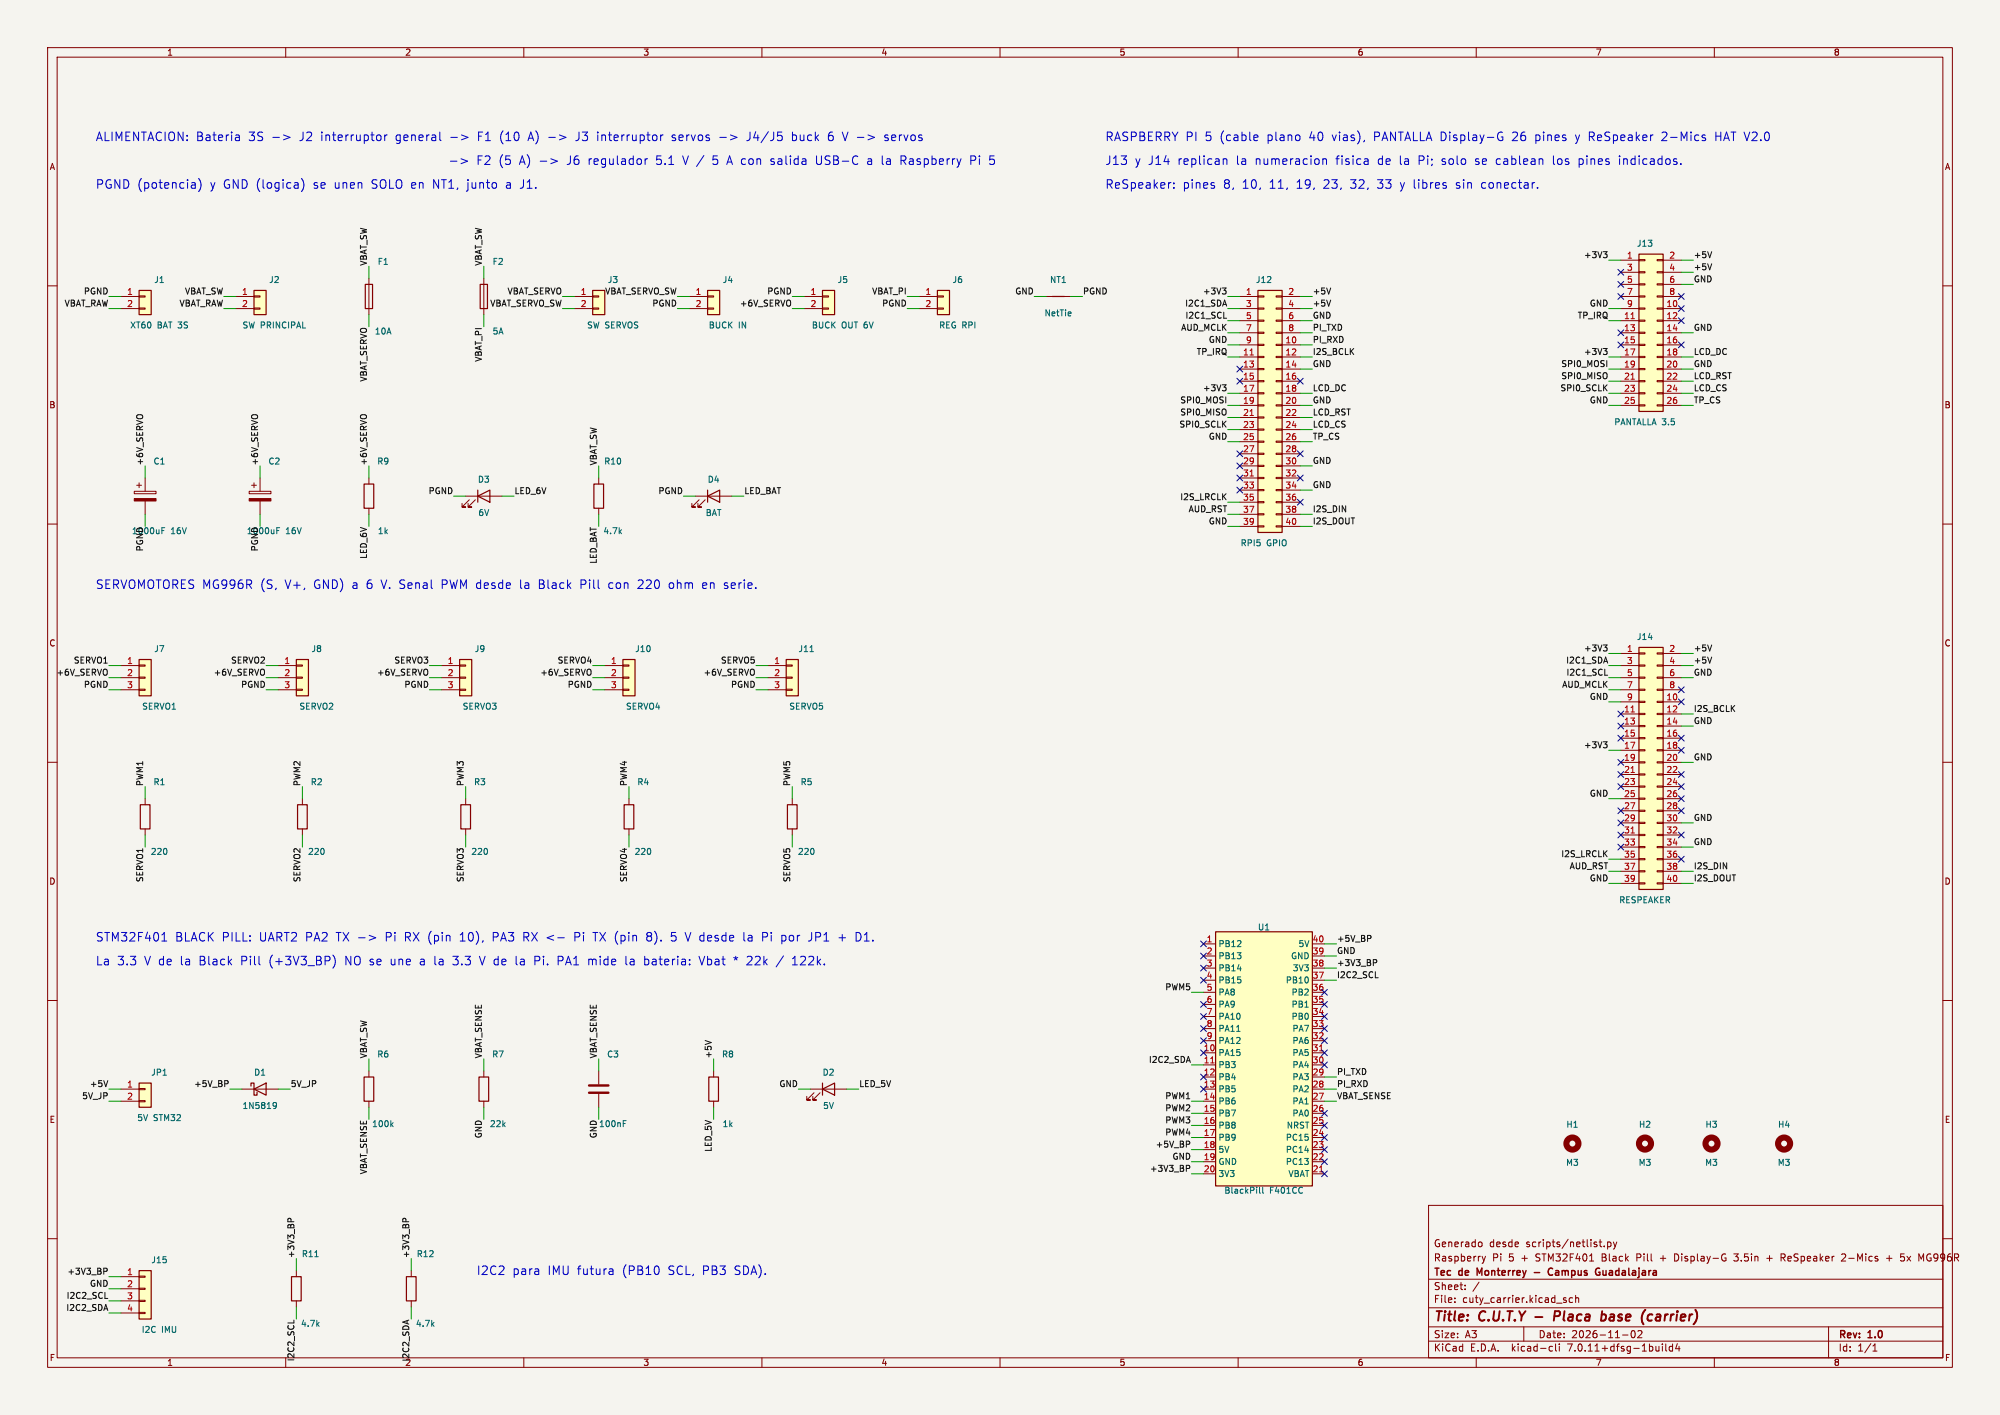
[picture p27: page 1]

ReSpeaker: pines 8, 10, 11, 19, 23, 32, 33 y libres sin conectar.

SERVOMOTORES MG996R (S, V+, GND) a 6 V. Senal PWM desde la Black Pill con 220 ohm en serie.

I2C2 para IMU futura (PB10 SCL, PB3 SDA).
