santi-bnt/C.U.T.Y/hardware/electronics/kicad/cuty_carrier/fab/cuty_carrier_capa_superior.pdf

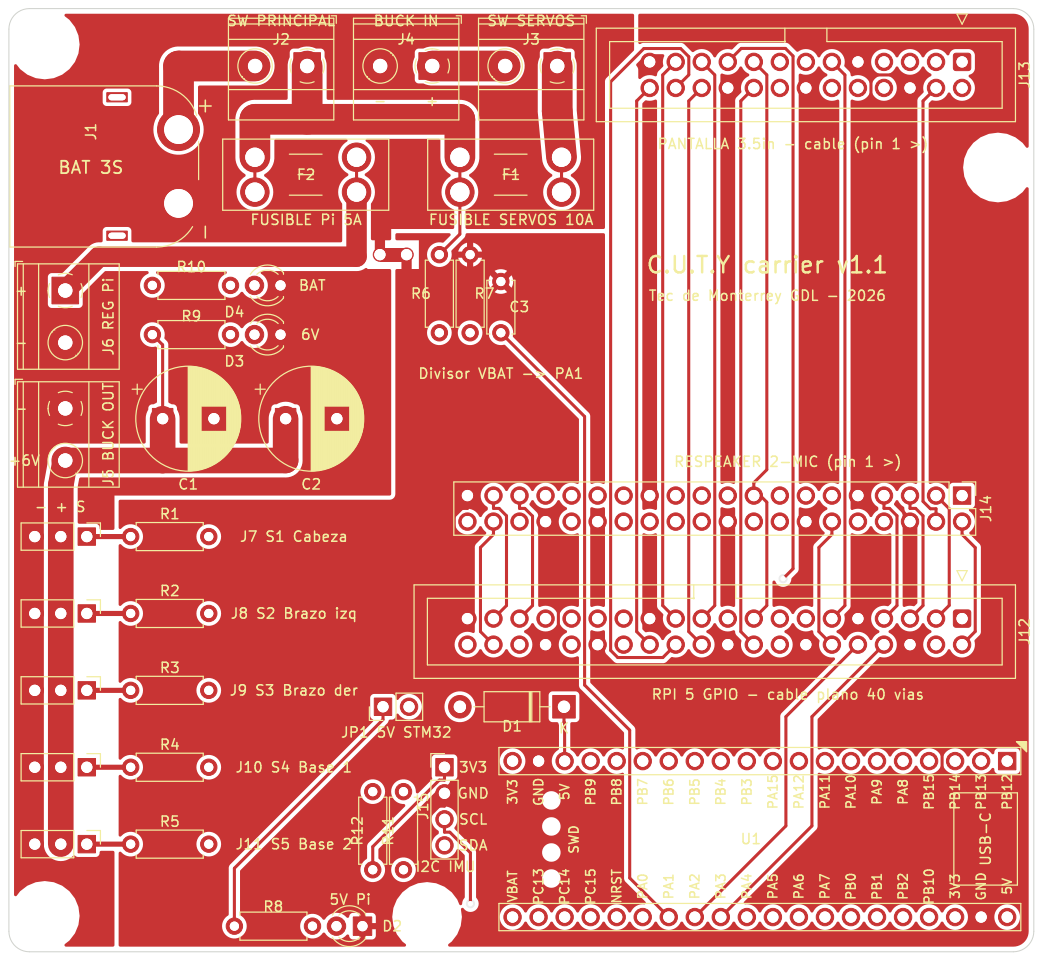
[picture p28: page 1]
