santi-bnt/C.U.T.Y/(list of files, drawings)

Other design files:
hardware/electronics/kicad/cuty_carrier/scripts/_route/board.dsn
