santi-bnt/C.U.T.Y/hardware/electronics/kicad/cuty_carrier/cuty_carrier.kicad_pcb

## KiCad design hardware/electronics/kicad/cuty_carrier/cuty_carrier.kicad_pcb (2026-11-09)

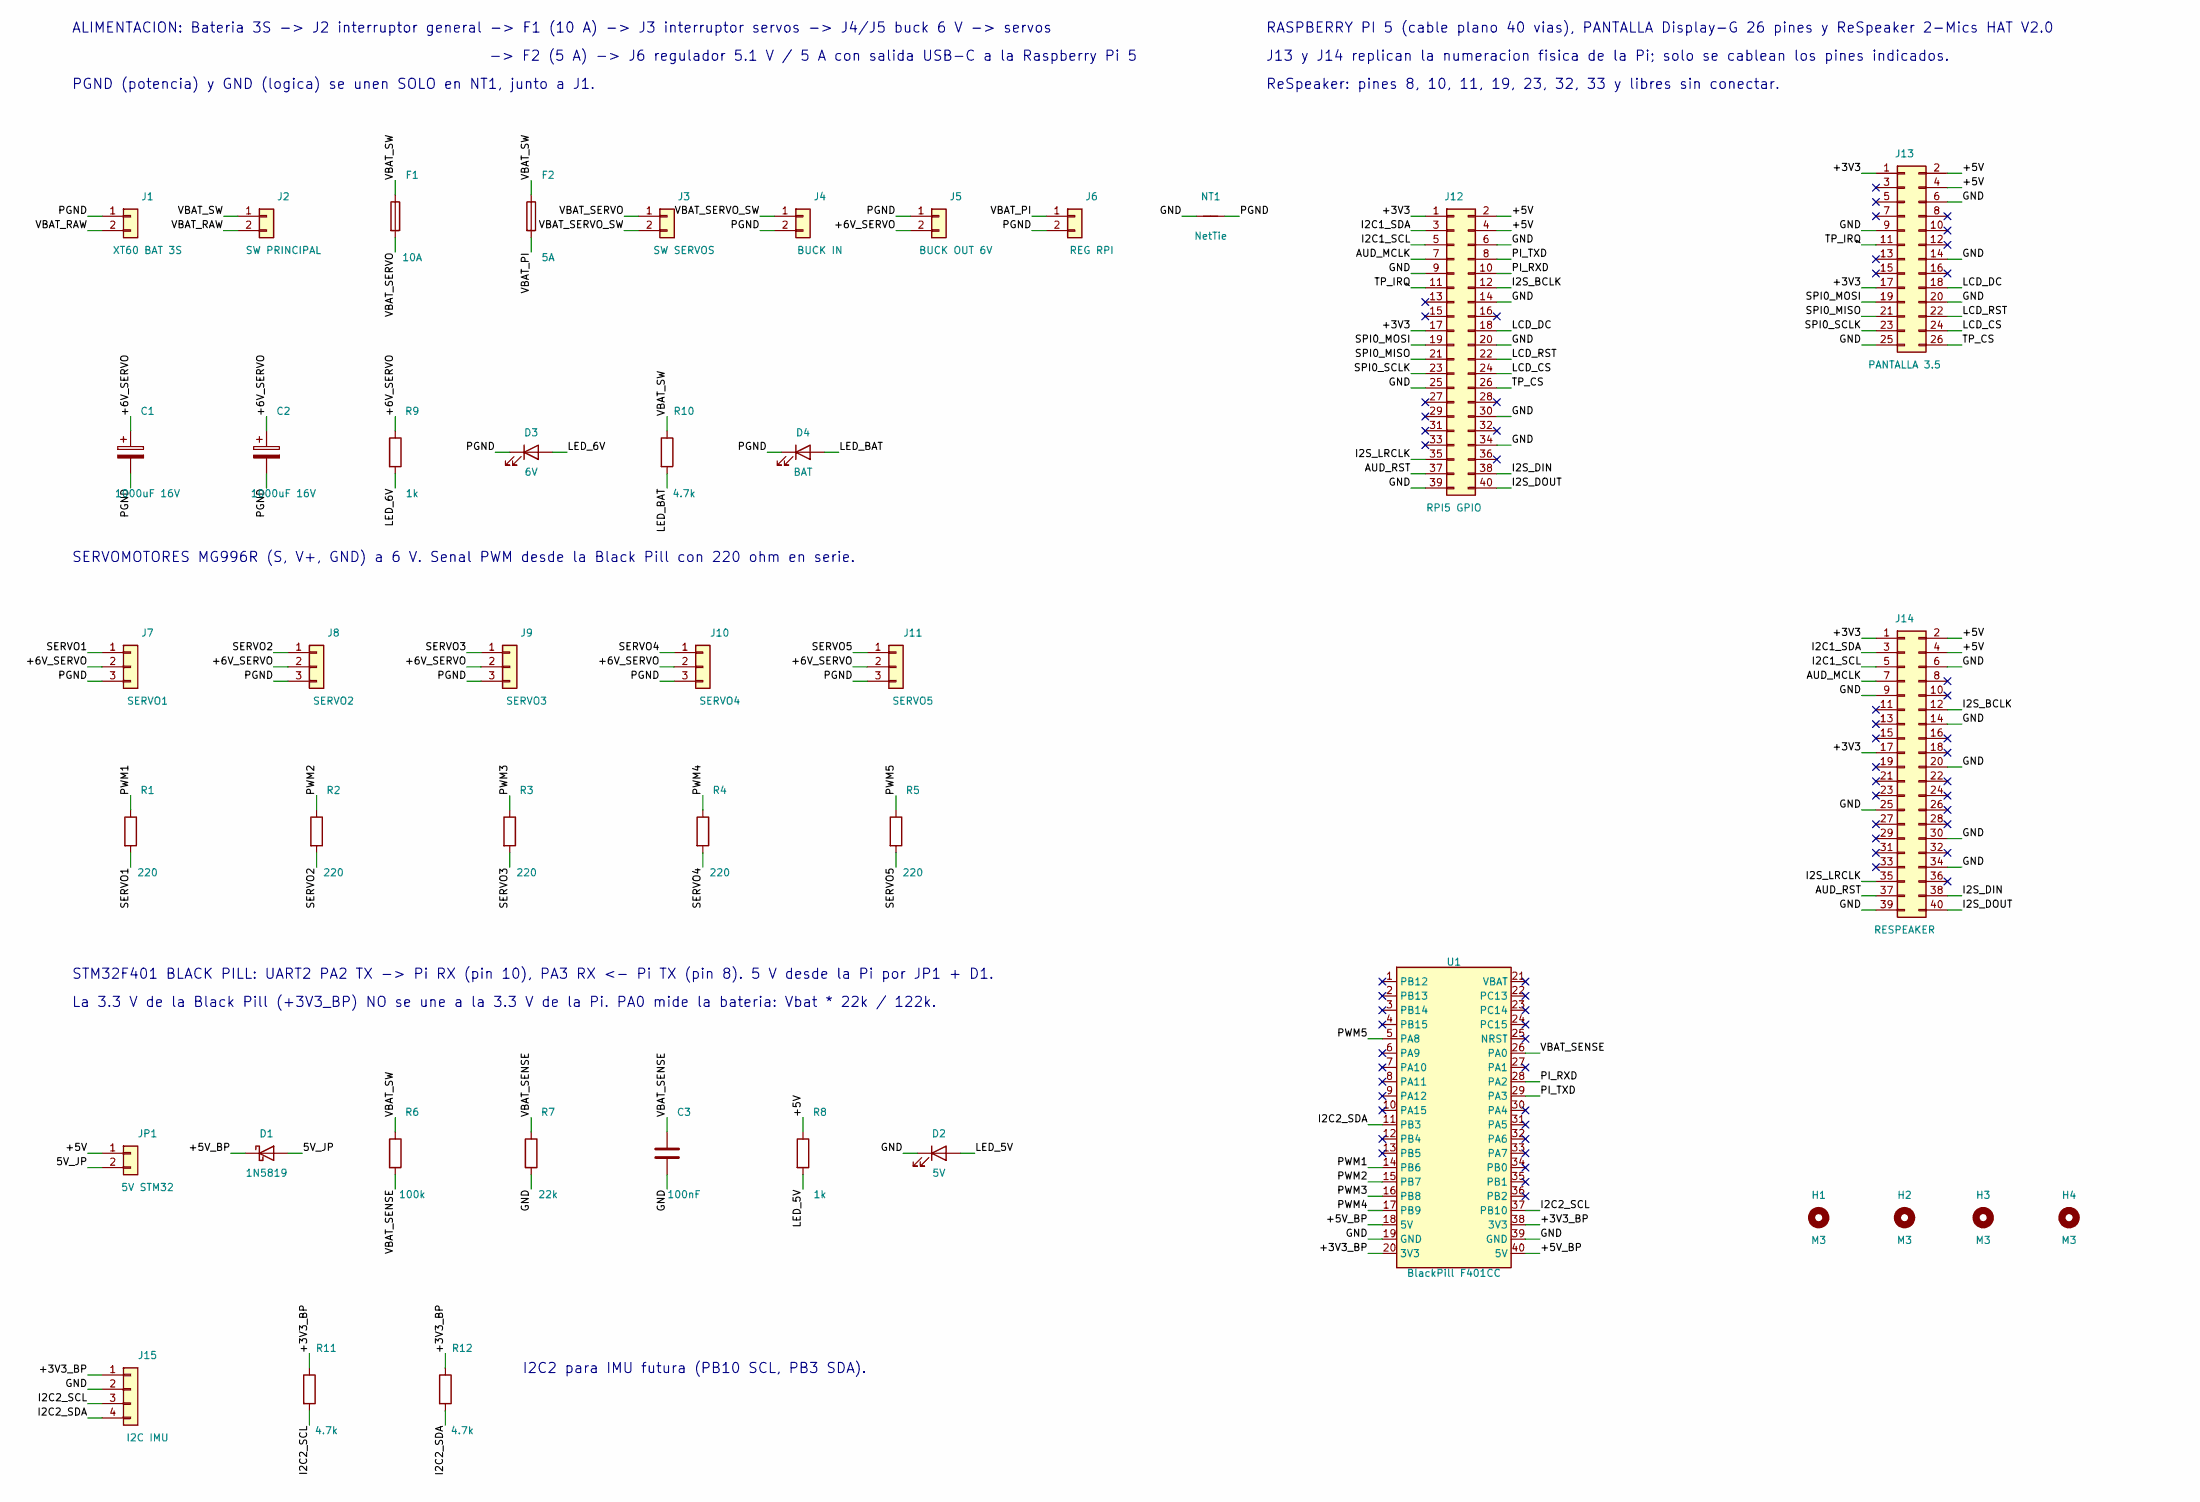
[picture p29: schematic cuty_carrier.kicad_sch, C.U.T.Y - Placa base (carrier)]

Parts:
C1, C2: 1000uF 16V; CP_Radial_D10.0mm_P5.00mm
C3: 100nF; C_Disc_D5.0mm_W2.5mm_P5.00mm
D1: 1N5819; D_DO-41_SOD81_P10.16mm_Horizontal
D2: 5V; LED_D3.0mm
D3: 6V; LED_D3.0mm
D4: BAT; LED_D3.0mm
F1: 10A; Fuseholder_Blade_Mini_Keystone_3568
F2: 5A; Fuseholder_Blade_Mini_Keystone_3568
H1, H2, H3, H4: M3; MountingHole_3.2mm_M3
J1: XT60 BAT 3S; AMASS_XT60PW-M_1x02_P7.20mm_Horizontal
J2: SW PRINCIPAL; TerminalBlock_Phoenix_MKDS-1,5-2-5.08_1x02_P5.08mm_Horizont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
J3: SW SERVOS; TerminalBlock_Phoenix_MKDS-1,5-2-5.08_1x02_P5.08mm_Horizont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
J4: BUCK IN; TerminalBlock_Phoenix_MKDS-1,5-2-5.08_1x02_P5.08mm_Horizont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
J5: BUCK OUT 6V; TerminalBlock_Phoenix_MKDS-1,5-2-5.08_1x02_P5.08mm_Horizont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
J6: REG RPI; TerminalBlock_Phoenix_MKDS-1,5-2-5.08_1x02_P5.08mm_Horizont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
J7: SERVO1; PinHeader_1x03_P2.54mm_Vertical
J8: SERVO2; PinHeader_1x03_P2.54mm_Vertical
J9: SERVO3; PinHeader_1x03_P2.54mm_Vertical
J10: SERVO4; PinHeader_1x03_P2.54mm_Vertical
J11: SERVO5; PinHeader_1x03_P2.54mm_Vertical
J12: RPI5 GPIO; IDC-Header_2x20_P2.54mm_Vertical
J13: PANTALLA 3.5; PinHeader_2x13_P2.54mm_Vertical
J14: RESPEAKER; PinHeader_2x20_P2.54mm_Vertical
J15: I2C IMU; PinHeader_1x04_P2.54mm_Vertical
JP1: 5V STM32; PinHeader_1x02_P2.54mm_Vertical
NT1: NetTie; NetTie-2_THT_Pad1.0mm
R1, R2, R3, R4, R5: 220; R_Axial_DIN0207_L6.3mm_D2.5mm_P7.62mm_Horizontal
R6: 100k; R_Axial_DIN0207_L6.3mm_D2.5mm_P7.62mm_Horizontal
R7: 22k; R_Axial_DIN0207_L6.3mm_D2.5mm_P7.62mm_Horizontal
R8, R9: 1k; R_Axial_DIN0207_L6.3mm_D2.5mm_P7.62mm_Horizontal
R10, R11, R12: 4.7k; R_Axial_DIN0207_L6.3mm_D2.5mm_P7.62mm_Horizontal
U1: BlackPill F401CC; WeAct_BlackPill_Socket

Connections:
5V_JP: D1.2 (A), JP1.2
+3V3: J12.1, J12.17, J13.1, J13.17, J14.1, J14.17
+3V3_BP: J15.1, R11.1, R12.1, U1.20 (3V3), U1.38 (3V3)
+5V: J12.2, J12.4, J13.2, J13.4, J14.2, J14.4, JP1.1, R8.1
+5V_BP: D1.1 (K), U1.18 (5V), U1.40 (5V)
+6V_SERVO: C1.1, C2.1, J5.2, J7.2, J8.2, J9.2, J10.2, J11.2, R9.1
AUD_MCLK: J12.7, J14.7
AUD_RST: J12.37, J14.37
GND: C3.2, D2.1 (K), J12.6, J12.9, J12.14, J12.20, J12.25, J12.30, J12.34, J12.39, J13.6, J13.9, J13.14, J13.20, J13.25, J14.6, J14.9, J14.14, J14.20, J14.25, J14.30, J14.34, J14.39, J15.2, NT1.1, R7.2, U1.19 (GND), U1.39 (GND)
I2C1_SCL: J12.5, J14.5
I2C1_SDA: J12.3, J14.3
I2C2_SCL: J15.3, R11.2, U1.37 (PB10)
I2C2_SDA: J15.4, R12.2, U1.11 (PB3)
I2S_BCLK: J12.12, J14.12
I2S_DIN: J12.38, J14.38
I2S_DOUT: J12.40, J14.40
I2S_LRCLK: J12.35, J14.35
LCD_CS: J12.24, J13.24
LCD_DC: J12.18, J13.18
LCD_RST: J12.22, J13.22
LED_5V: D2.2 (A), R8.2
LED_6V: D3.2 (A), R9.2
LED_BAT: D4.2 (A), R10.2
PGND: C1.2, C2.2, D3.1 (K), D4.1 (K), J1.1, J4.2, J5.1, J6.2, J7.3, J8.3, J9.3, J10.3, J11.3, NT1.2
PI_RXD: J12.10, U1.28 (PA2)
PI_TXD: J12.8, U1.29 (PA3)
PWM1: R1.1, U1.14 (PB6)
PWM2: R2.1, U1.15 (PB7)
PWM3: R3.1, U1.16 (PB8)
PWM4: R4.1, U1.17 (PB9)
PWM5: R5.1, U1.5 (PA8)
SERVO1: J7.1, R1.2
SERVO2: J8.1, R2.2
SERVO3: J9.1, R3.2
SERVO4: J10.1, R4.2
SERVO5: J11.1, R5.2
SPI0_MISO: J12.21, J13.21
SPI0_MOSI: J12.19, J13.19
SPI0_SCLK: J12.23, J13.23
TP_CS: J12.26, J13.26
TP_IRQ: J12.11, J13.11
VBAT_PI: F2.2, J6.1
VBAT_RAW: J1.2, J2.2
VBAT_SENSE: C3.1, R6.2, R7.1, U1.26 (PA0), U1.27 (PA1)
VBAT_SERVO: F1.2, J3.1
VBAT_SERVO_SW: J3.2, J4.1
VBAT_SW: F1.1, F2.1, J2.1, R6.1, R10.1

Notes on the sheet:
ALIMENTACION: Bateria 3S -> J2 interruptor general -> F1 (10 A) -> J3 interruptor servos -> J4/J5 buck 6 V -> servos
-> F2 (5 A) -> J6 regulador 5.1 V / 5 A con salida USB-C a la Raspberry Pi 5
PGND (potencia) y GND (logica) se unen SOLO en NT1, junto a J1.
SERVOMOTORES MG996R (S, V+, GND) a 6 V. Senal PWM desde la Black Pill con 220 ohm en serie.
RASPBERRY PI 5 (cable plano 40 vias), PANTALLA Display-G 26 pines y ReSpeaker 2-Mics HAT V2.0
J13 y J14 replican la numeracion fisica de la Pi; solo se cablean los pines indicados.
ReSpeaker: pines 8, 10, 11, 19, 23, 32, 33 y libres sin conectar.
STM32F401 BLACK PILL: UART2 PA2 TX -> Pi RX (pin 10), PA3 RX <- Pi TX (pin 8). 5 V desde la Pi por JP1 + D1.
La 3.3 V de la Black Pill (+3V3_BP) NO se une a la 3.3 V de la Pi. PA0 mide la bateria: Vbat * 22k / 122k.
I2C2 para IMU futura (PB10 SCL, PB3 SDA).

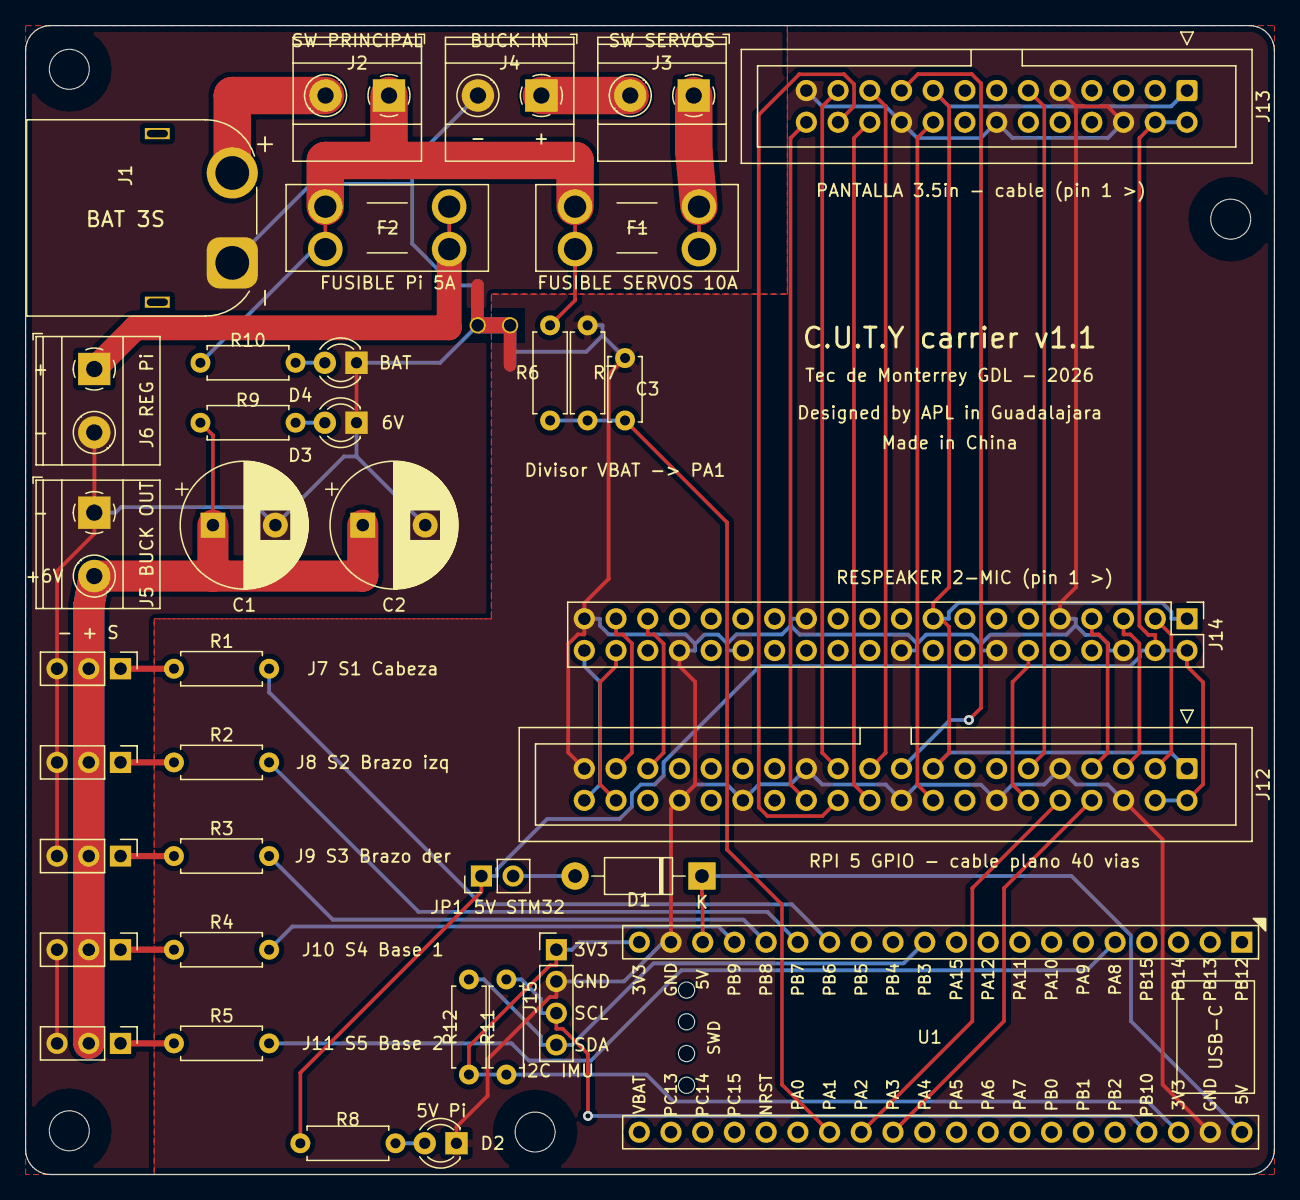
[picture p30: board cuty_carrier.kicad_pcb from above]

Board: 2 copper layers, 100.0 x 92.0 mm, 43 parts (0 on the bottom side), 47 nets.
