santi-bnt/C.U.T.Y/(commit log)

2026-10-31 Integrate Raspberry touchscreen and simplify repository layout
2026-11-02 Revert "Integrate Raspberry touchscreen and simplify repository layout"
    This reverts commit ffe5939d078472bd8820be1a31de01aa5e8e16b0.
2026-11-02 Reapply "Integrate Raspberry touchscreen and simplify repository layout"
    This reverts commit 8be944e6f56e7af1bde8714a3e2ee12116c56fa5.
2026-11-02 fix: detect SPI touchscreen independently of HDMI
2026-11-03 feat(face): cara animada con ojos que siguen a la persona y boca con lip sync
    - cuty.face: renderer con ojos cute (iris, brillos, párpados, parpadeo),
    10 expresiones, mirada con resorte estable, boca que se abre con la voz
    - cuty.face.framebuffer: RGB565 con NumPy y escritura solo de filas cambiadas
    - cuty.vision: cámara Pi/USB, detector YuNet (Haar de respaldo), tracker
    - cuty.audio.lipsync + cuty.face.link: la voz envía expresiones y nivel de
    boca por UDP local; app.py lo conecta
    - launcher: modo C.U.T.Y anima la cara a 20 fps, toque = parpadeo, 5 s = menú
    - tests y documentación
2026-11-03 feat: stream Raspberry reply audio to PC over SSH
2026-11-03 docs: use verified PC speaker device in audio example
2026-11-03 feat(hardware): placa base C.U.T.Y v1.0 en KiCad lista para PCBWay
    - Esquematico y PCB de 2 capas (100x92 mm, THT) generados desde scripts/netlist.py
    - Raspberry Pi 5 (IDC 40), Display-G 26 pines, ReSpeaker 2-Mics, Black Pill
    STM32F401 en zocalos, 5 servos MG996R a 6 V con PWM PB6-PB9/PA8
    - Potencia: XT60 3S, fusibles mini blade 10 A / 5 A, bornes para interruptores,
    buck de servos y regulador de la Pi; PGND y GND unidos solo en NT1
    - UART Pi<->STM32 cruzado, divisor de bateria a PA0, header I2C2 para IMU
    - Gerbers, taladros, BOM, PDF del esquematico, render y reporte DRC
    Claude-Session: https://claude.ai/code/session_0175C68edLn88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
2026-11-03 fix(hardware): placa base v1.1, revision final antes de PCBWay
    - Black Pill: footprint rehecho con la numeracion DIP y geometria del STEP
    oficial de WeAct (fila VBAT..5V invertida y filas cambiadas en v1.0; filas
    a 15.215 mm); barrenos libres para el header SWD
    - Divisor de bateria en PA1 (PA0 tiene el boton KEY del modulo)
    - Pantalla por cable: J13 pasa a box header 2x13 con llave
    - ReSpeaker sube 2 mm para no chocar con el cable de la Pi
    - XT60 al ras del borde; pads de retorno PGND con union solida
    - Sin cobre bajo los tornillos M3; serigrafia >= 1 mm y sin encimados
    - verify_spec.py: la PCB se comprueba contra las tablas de info.md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
2026-11-03 chore(hardware): verificacion de Gerbers y serigrafia de la Black Pill mas legible
    - verify_gerbers.py: rasteriza el cobre de los Gerbers, une capas por los
    taladros metalizados y comprueba 0 cortos, 0 abiertos, tierra en un solo
    punto (NT1), taladro y mascara en cada pad
    - Nombres de pines de la Black Pill a 0.9 mm / trazo 0.15 mm (minimo PCBWay)
    Claude-Session: https://claude.ai/code/session_0175C68edLn88CMRihygtZo2
2026-11-04 docs: align STM32F401 hardware and implemented feature roadmap
2026-11-05 assets: preserve supplied V23 assembly export
2026-11-05 feat(web): replace V16 viewer asset with V23 assembly
2026-11-05 fix(web): restore first original V16 assembly without hat
2026-11-05 feat(hardware): archivos de ensamble PCBA para PCBWay
    - fab/pcba: BOM turnkey con numeros de parte del fabricante (xlsx/csv),
    centroid (xlsx/csv), dibujo de ensamble con marcas de polaridad (PDF/SVG)
    e instrucciones de pedido paso a paso (LEEME_PCBA.md)
    - scripts/gen_pcba.py, gen_asm_svg.py, gen_asm_pdf.py los regeneran desde la PCB;
    gen_pcba.py se detiene si una referencia falta o se repite en el BOM
    - README: la placa se pide ensamblada; soldar a mano queda como alternativa
    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
2026-11-05 feat(cad): carcasa imprimible V17 «Nido» para armar sin pegamento
    - 30 piezas en STL ya orientadas para la cama de 180 mm (Bambu A1 mini)
    - nido con gimbal de dos servos, cajon de bateria en rieles y bayoneta;
    nucleo con plataforma, columna, hombros, rack de potencia y cubo del cuello;
    panza y espalda que cierran los brazos; casco con visor, orejas y antena
    - fuente parametrica en CadQuery (fuente_cad/): build, export a STEP/STL,
    revision de choques en reposo y en movimiento (meshcheck) y de zonas de cables
    - verificacion: 0 interferencias, 18 zonas de conectores libres; limites
    cabeceo +-18, balanceo +-15, cabeza +-90, brazos +-120 grados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
2026-11-05 feat(web): show black V17 assembly with integrated animated LCD
2026-11-06 refactor: keep robot entry points and CAD assets inside project folders
2026-11-06 feat(web): add cinematic Nido assembly and confirmed hardware explorer
2026-11-06 fix(web): use final 11-pin ReSpeaker hookup
2026-11-08 fix(cad): carcasa V17 ajustada a las piezas compradas y a la tornilleria
    - ejes del gimbal (B4, K1): tornillo M4x30 autorroscante, libre en una
    mejilla y roscado en la otra, sin tuerca
    - manivelas G2/G3: cubo de 6.5 mm con piso para la cabeza del tornillo
    allen M3x8 que va al eje del servo
    - Pi 5 e IMU en M2 (K1), barras de pantalla en M2x10 (H3), pilares del
    servo de cabeza en M3x10 (H5)
    - rack de potencia (K5): buck y regulador a la medida real, ranura USB-C
    mas ancha y paso de cables
    - cajon de bateria (B1, B2, B3) para una 3S 2200 mAh de hasta 109 mm
    - verificacion: 111 cuerpos, 0 interferencias, 18/18 zonas libres,
    34 posturas sin choque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
2026-11-08 fix(cad): visor, barras y rejilla con las medidas reales de las piezas
    Medidas tomadas por el equipo con vernier:
    - pantalla Display-G 85 x 55.3 x 5.8 (el modelo suponia ~10 mm de grueso;
    las barras habrian quedado flojas): barras y bosses a la medida
    - camara Arducam OV5647 24.4 x 23.3, 7.2 de fondo: el visor (H3) trae una
    cuna con 4 apoyos, 2 guias con pie y 2 bosses; una barrita nueva en H4 la
    aprieta por detras con 2 x M2x10, asi no depende de donde caigan sus
    agujeros. Ventana con bolsillo de 12.4 mm para el portalente
    - bocina 2 W 35.4 x 25 x 5.5 (antes redonda de 40 mm): bolsillo acostado
    en la rejilla (S3) con tope y salida de sonido
    - Raspberry Pi 5 90.3 x 56 x 18 (puertos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
2026-11-08 docs(hardware): pedido real de la placa en JLCPCB y lista de materiales
    - fab/jlcpcb: BOM y CPL tal como se subieron a JLCPCB, que piezas soldo
    JLCPCB (37) y cuales van a mano desde Mouser (F1/F2, fusibles, jumper),
    y las correcciones del visor (J1 90 grados, D2-D4 180 grados)
    - docs/bom.md: lista de materiales real (JLCPCB, Mouser, Amazon con ASIN
    y lo que ya tenia el equipo, con medidas)
    - hardware/README: la placa se pidio a JLCPCB; PCBWay queda de alternativa
    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
2026-11-09 docs(web): sync latest Nido CAD and carrier order
2026-11-09 web: rebuild interactive model from Nov 6 Nido CAD
2026-11-10 fix(web): restore dark wiring connections table
2026-11-10 fix(web): align wiring evidence with site branding
2026-11-10 fix(web): improve wiring contrast and robot logo
2026-11-10 fix(web): make V17 assembly section white
2026-11-10 fix(web): tighten mobile hero spacing
2026-11-10 fix(music): allow local track to finish
2026-11-10 chore(cad): quitar la firma de APL debajo de la base
    El piso de la base (B2) solo lleva grabado "C.U.T.Y · V17 Nido" por
    debajo. El hueco del texto se rellena dentro de la misma placa del piso,
    asi que no cambia ninguna otra pieza ni las verificaciones.
    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
2026-11-11 fix(cad): cubierta B1 imprimible (base plana y techo interior a 45 grados)
    La primera impresion de la cubierta fallo: el borde de abajo era
    redondeado hacia adentro y el muro empezaba en el aire, solo 61 mm2
    tocaban la cama, y el techo del hueco interior era casi plano, lo que
    pedia soportes de 58 mm pegados al muro.
    - borde de abajo: anillo plano de 2.2 mm con chaflan de 0.8 mm
    (831 mm2 en la cama); el muro queda recto a 86 mm, al ras con la
    cara del cajon
    - techo del hueco interior a 45 grados: ya no lleva soportes adentro
    - solo pide soportes bajo la orilla del agujero central y sobre la
    abertura del cajon, ambos desde la cama
    - LEEME: brim solo interior de 5 mm, soportes arbol sol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
2026-11-13 fix(cad): primera capa plana en H1, S2, S3 y S4
    Revisé la primera capa de las 30 piezas y cuatro tocaban la cama con
    una puntita:
    - H1 (casco frontal): sin pernos de costura, se imprime plano sobre la
    costura. H2 conserva sus agujeros.
    - S2 (espalda): sin ceja de alineación, plana sobre la costura. Las
    mitades las ubican los clips de la plataforma y las orejas.
    - S3 (rejilla): recortada para que el marco de la bocina quede plano.
    - S4 (tapón USB): acostado sobre su cara plana.
    Las demás piezas no cambian. Renders y verificación actualizados.
    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
2026-11-13 fix(cad): bayoneta de la cubierta B1 alineada con los rieles
    Al girar la cubierta 14° para trabarla, la abertura del cajón quedaba
    desalineada con los rieles del piso: el cajón chocaba con la cubierta
    (1750 mm³) y ya no entraba. El modelo mostraba las pestañas en la
    entrada de la ranura, o sea destrabadas.
    Ahora la entrada de cada ranura está 14° antes de la pestaña: la
    cubierta se baja girada y se gira de regreso, y queda trabada justo
    cuando la abertura está sobre los rieles. Revisado: trabada no toca el
    piso ni el cajón, gira libre hasta la entrada, sale libre ahí y
    trabada no se levanta.
    Solo cambia B1; hay que reimprimirla si ya se imprimió.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
2026-11-13 feat(cad): carcasa V17 fija sobre un pedestal bajo
    Variante de la V17 sin gimbal: solo se mueven la cabeza (±90°) y los
    brazos (±120°). Sin la bola del gimbal el cuerpo termina plano justo
    debajo de la rejilla y se para en un pedestal de Ø126 × 34 mm, así el
    robot mide 31.6 cm (4.9 cm menos que con nido). Conserva todos los
    espacios de la versión con gimbal: placa, Pi 5, batería y cajón, rack
    de potencia, pantalla, cámara, bocina, ReSpeaker e interruptores.
    - Misma fuente; se construye con CUTY_FIJO=1 (sale en out_fijo/, con
    la mesa en z = 0). Sin la variable la versión con gimbal sale igual.
    - pedestal.py: B1 pedestal (se imprime boca abajo, sin soportes), B2
    piso con bayon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
2026-11-13 Keep Cuty name from switching languages
